MarcinWojewodzic/C5/Hardware/C5W1B1V1.0/Kicad/3D/MP34DT05TR-A.stp

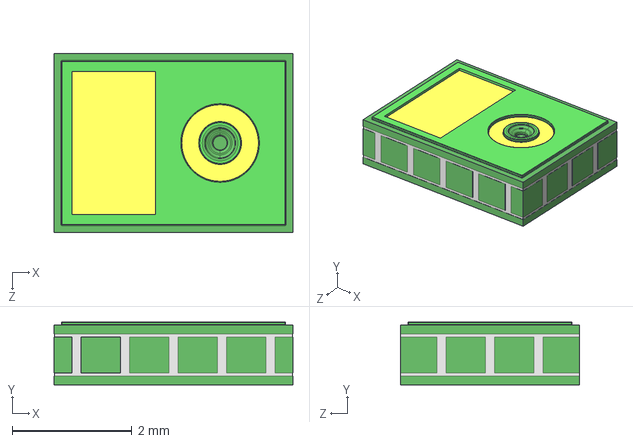
[picture p1: CAD file, 2024-11-15]
Hardware/C5W1B1V1.0/Kicad/3D/MP34DT05TR-A.stp
4.00 x 1.05 x 3.00 mm
