MarcinWojewodzic/C5/Hardware/C5W1B1V1.0/Kicad/3D/RBR10BM60AFHTL.stp

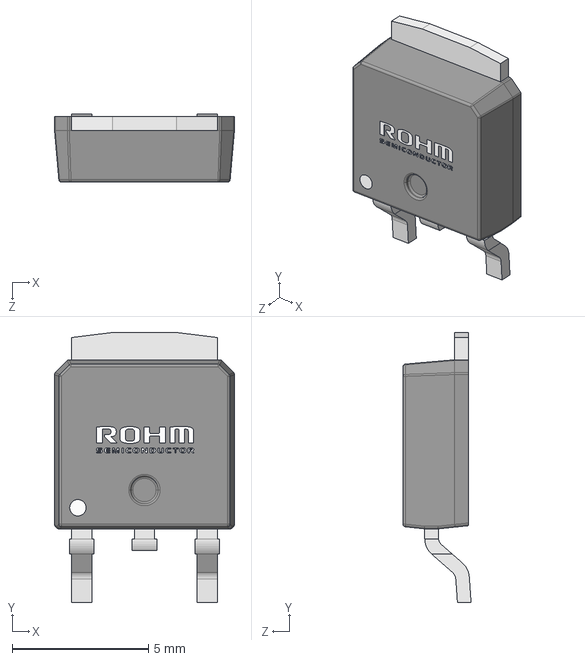
[picture p2: CAD file, 2024-11-08]
Hardware/C5W1B1V1.0/Kicad/3D/RBR10BM60AFHTL.stp
6.60 x 9.90 x 2.50 mm
ROHM TO-252
Rohm Logo-LAPTOP-NQA1DCQ3
