MarcinWojewodzic/C5/Hardware/C5W1B1V1.0/Kicad/3D/SRN6045TA-101M.stp

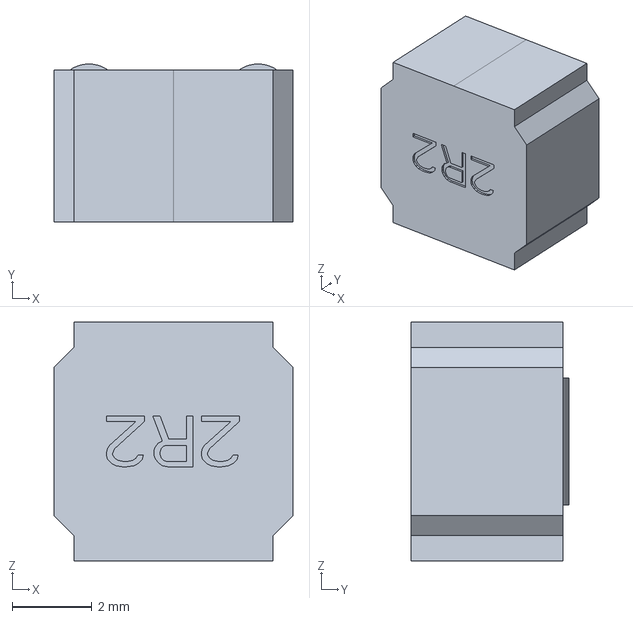
[picture p3: CAD file, 2024-06-30]
Hardware/C5W1B1V1.0/Kicad/3D/SRN6045TA-101M.stp
5.99 x 3.96 x 5.99 mm
