MarcinWojewodzic/C5/Hardware/C5W1B1V1.0/Kicad/3D/0.96in Color OLED.stp

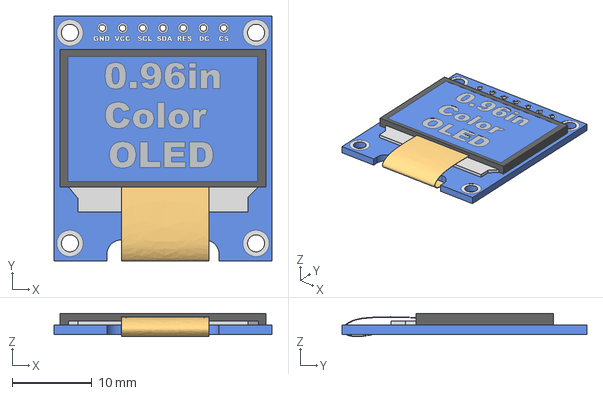
[picture p4: CAD file, 2024-06-27]
Hardware/C5W1B1V1.0/Kicad/3D/0.96in Color OLED.stp
27.4 x 30.8 x 2.92 mm
