MarcinWojewodzic/C5/Hardware/C5W1B1V1.0/Kicad/3D/ESP32-C3-WROOM-02-N4.stp

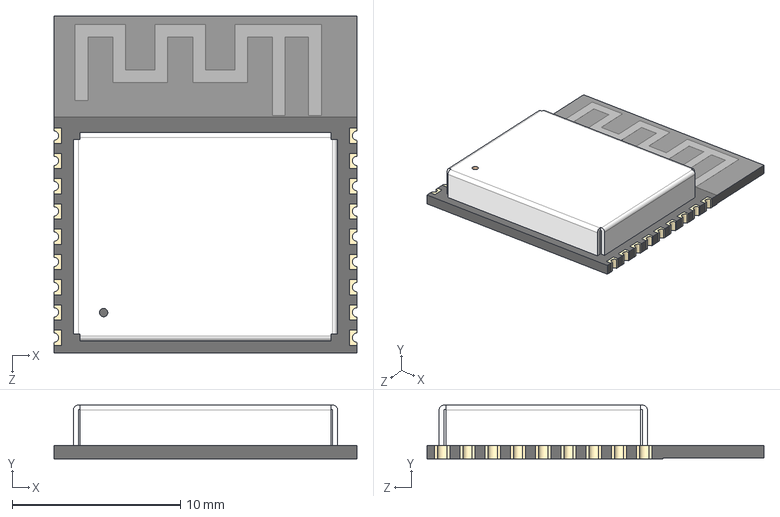
[picture p5: CAD file, 2024-06-08]
Hardware/C5W1B1V1.0/Kicad/3D/ESP32-C3-WROOM-02-N4.stp
18.0 x 3.20 x 20.0 mm
