MarcinWojewodzic/C5/Hardware/C5W1B1V1.0/Kicad/3D/LSM303AHTR.stp

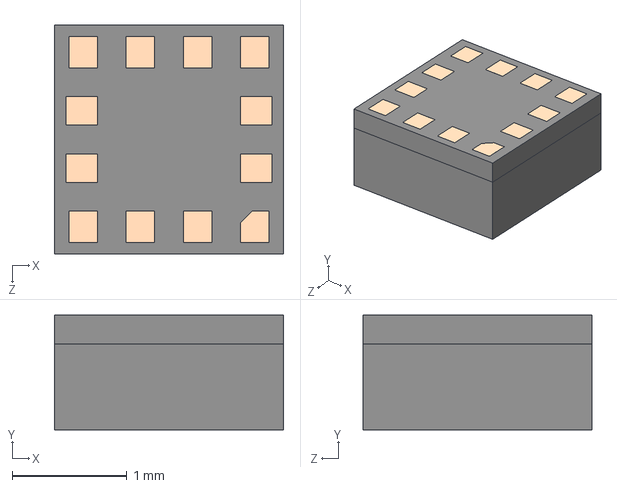
[picture p6: CAD file, 2024-06-08]
Hardware/C5W1B1V1.0/Kicad/3D/LSM303AHTR.stp
2.00 x 1.00 x 2.00 mm
