MarcinWojewodzic/C5/Hardware/C5W1B1V1.0/Kicad/3D/USB4105GFA120.step

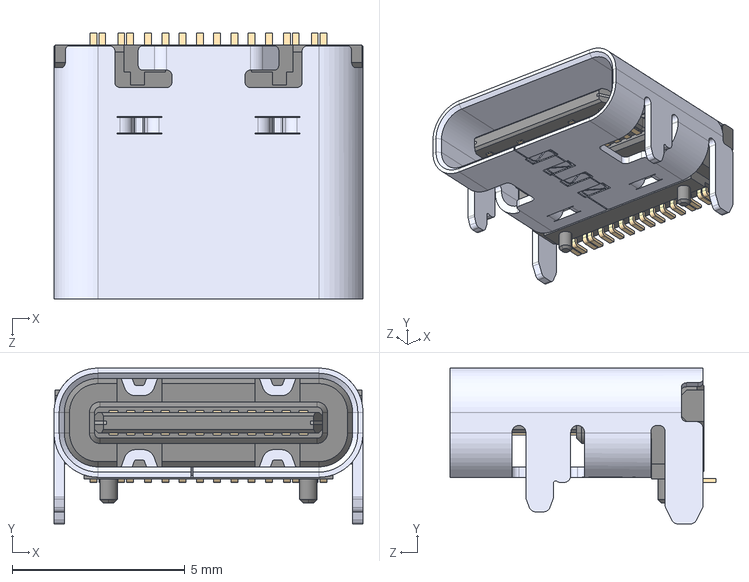
[picture p7: CAD file, 2024-06-08]
Hardware/C5W1B1V1.0/Kicad/3D/USB4105GFA120.step
8.94 x 4.51 x 7.71 mm
