MarcinWojewodzic/C5/Hardware/C5W1B1V1.0/Kicad/3D/USBLC6-2P6.stp

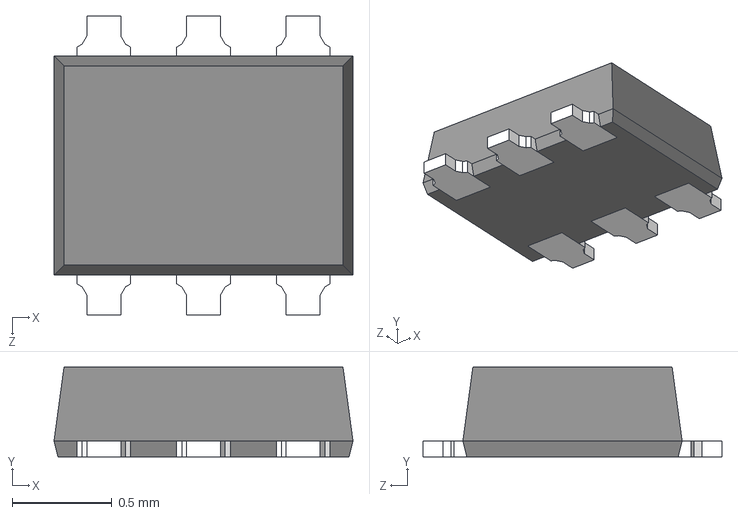
[picture p8: CAD file, 2024-06-08]
Hardware/C5W1B1V1.0/Kicad/3D/USBLC6-2P6.stp
1.50 x 0.45 x 1.50 mm
