MarcinWojewodzic/C5/Hardware/C5W1B1V1.0/Kicad/3D/VL53L0CXV0DH_1.stp

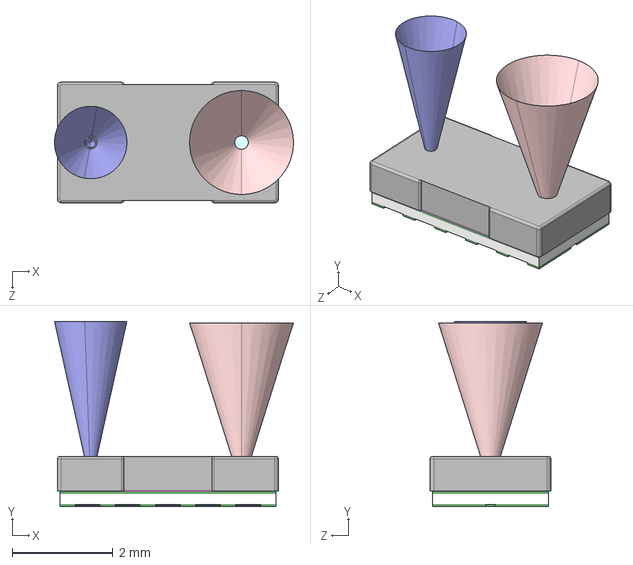
[picture p9: CAD file, 2024-06-08]
Hardware/C5W1B1V1.0/Kicad/3D/VL53L0CXV0DH_1.stp
4.75 x 3.68 x 2.40 mm
DM00266747 - VL53L0 Module
DM00266747 - VL53L0 Exclusion cones
