MarcinWojewodzic/C5/Hardware/C5W1B1V1.0/Kicad/3D/ECS-250-8-36CKM-TR3.stp

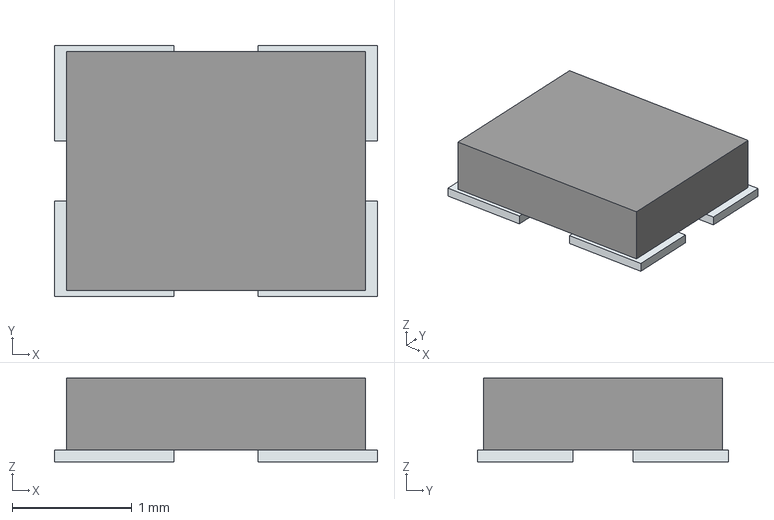
[picture p10: CAD file, 2024-06-08]
Hardware/C5W1B1V1.0/Kicad/3D/ECS-250-8-36CKM-TR3.stp
2.70 x 2.10 x 0.7 mm
Pins
