MarcinWojewodzic/C5/Hardware/C5W1B1V1.0/Kicad/3D/W25N512GVEIG.stp

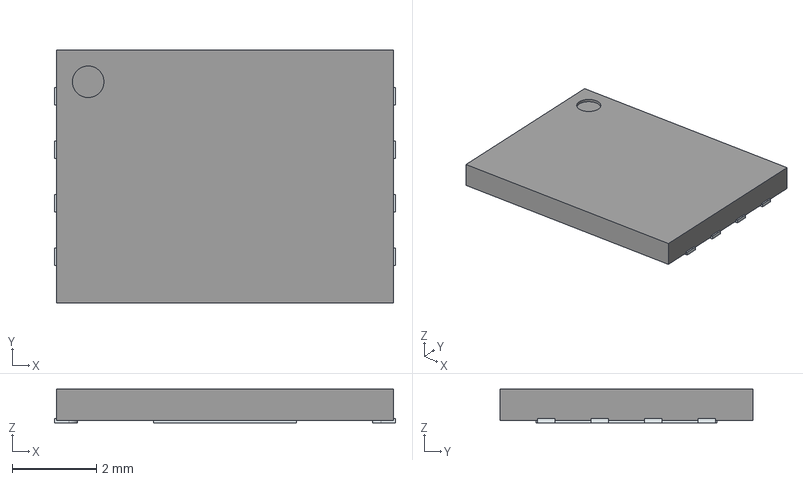
[picture p11: CAD file, 2024-06-08]
Hardware/C5W1B1V1.0/Kicad/3D/W25N512GVEIG.stp
8.10 x 6.00 x 0.8 mm
ThermalPin
PinsArrayLR
