MarcinWojewodzic/C5/Hardware/C5W1B1V1.0/Kicad/3D/ECS-.327-6-17X-C-TR.stp

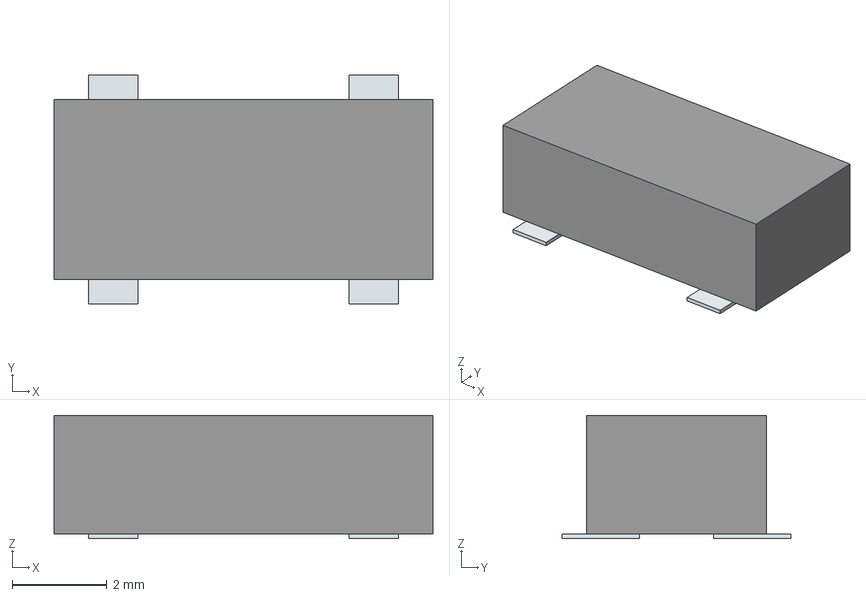
[picture p12: CAD file, 2024-06-08]
Hardware/C5W1B1V1.0/Kicad/3D/ECS-.327-6-17X-C-TR.stp
8.00 x 4.84 x 2.60 mm
Pins
