MarcinWojewodzic/C5/Hardware/C5W1B1V1.0/Kicad/3D/APS6404L-3SQR-SN.stp

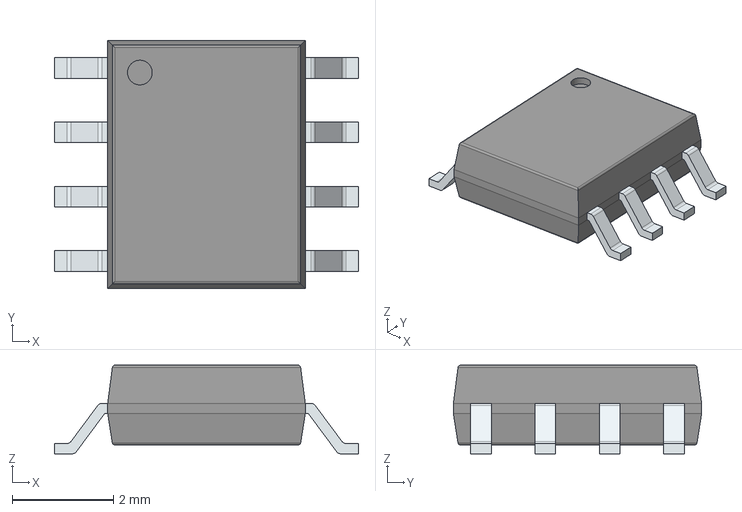
[picture p13: CAD file, 2024-06-08]
Hardware/C5W1B1V1.0/Kicad/3D/APS6404L-3SQR-SN.stp
6.00 x 4.90 x 1.75 mm
PinsArrayLR
