MarcinWojewodzic/C5/Hardware/C5W1B1V1.0/Kicad/3D/MB85RS512TPNF-G-JNERE1.stp

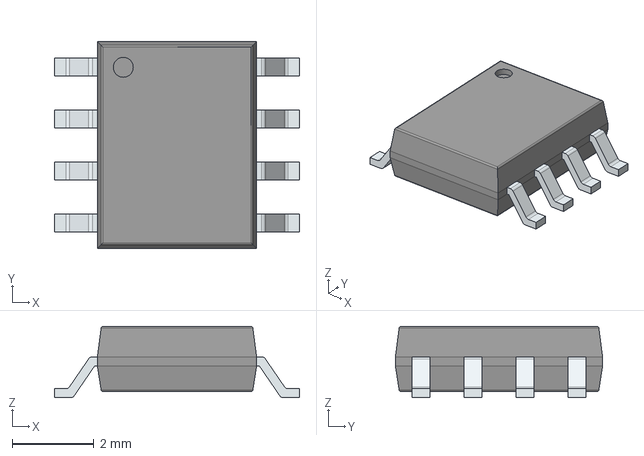
[picture p14: CAD file, 2024-06-08]
Hardware/C5W1B1V1.0/Kicad/3D/MB85RS512TPNF-G-JNERE1.stp
6.00 x 5.08 x 1.75 mm
PinsArrayLR
