MarcinWojewodzic/C5/Hardware/C5W1B1V1.0/Kicad/3D/BME688.stp

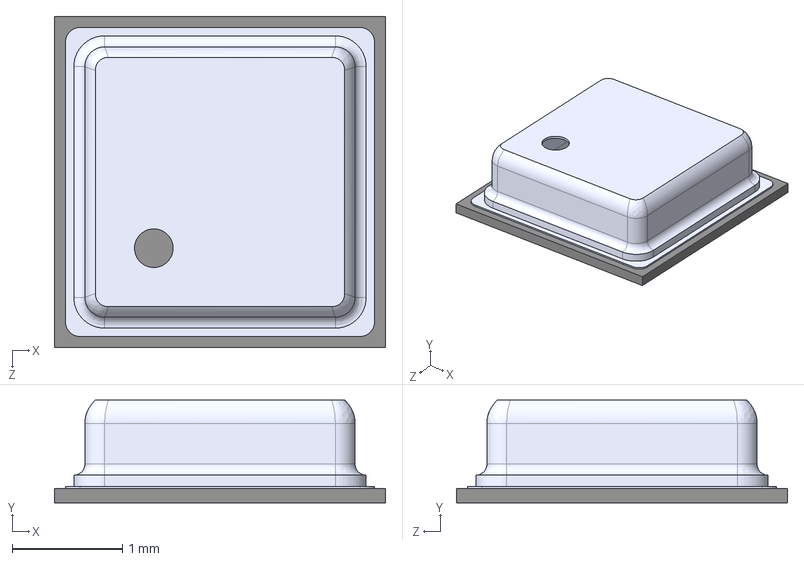
[picture p15: CAD file, 2023-05-07]
Hardware/C5W1B1V1.0/Kicad/3D/BME688.stp
3.00 x 0.93 x 3.00 mm
