MarcinWojewodzic/C5/Hardware/C5W1B1V1.0/Kicad/3D/LD39200PU33R.stp

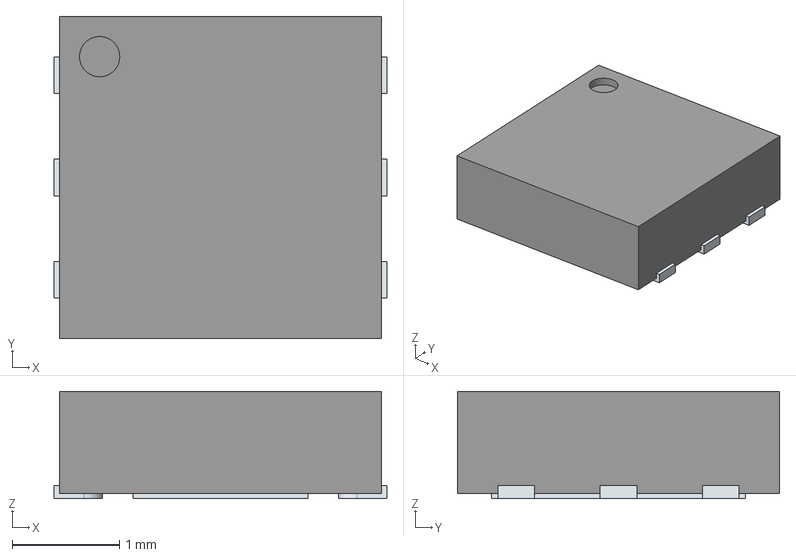
[picture p16: CAD file, 2024-11-08]
Hardware/C5W1B1V1.0/Kicad/3D/LD39200PU33R.stp
3.10 x 3.00 x 1.00 mm
ThermalPin
PinsArrayLR
