MarcinWojewodzic/C5/Hardware/C5W1B1V1.0/Kicad/3D/LMR62421XSD_NOPB.stp

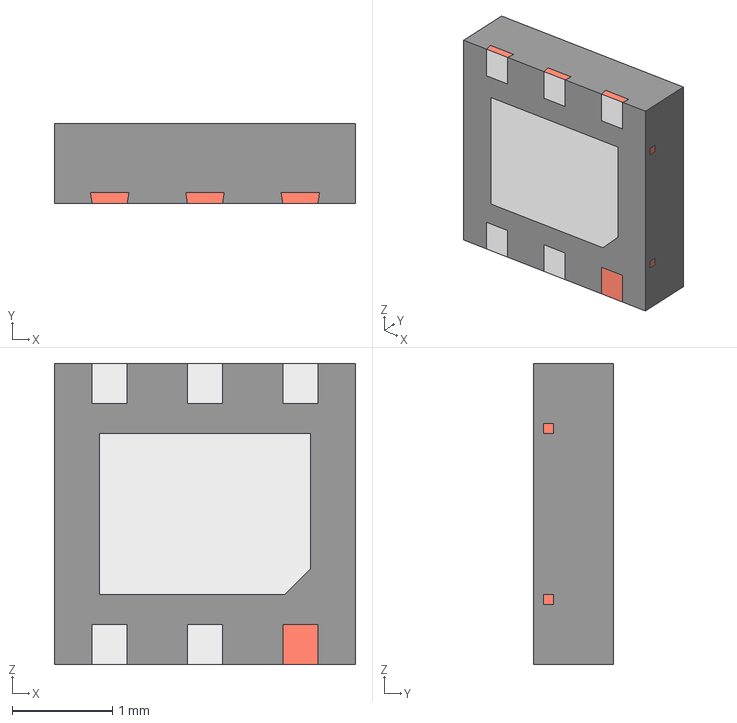
[picture p17: CAD file, 2024-06-30]
Hardware/C5W1B1V1.0/Kicad/3D/LMR62421XSD_NOPB.stp
3.00 x 0.8 x 3.00 mm
BODY_SDE06A
FRAME_SDE06A
