MarcinWojewodzic/C5/Hardware/C5W1B1V1.0/Kicad/3D/216990-0003.stp

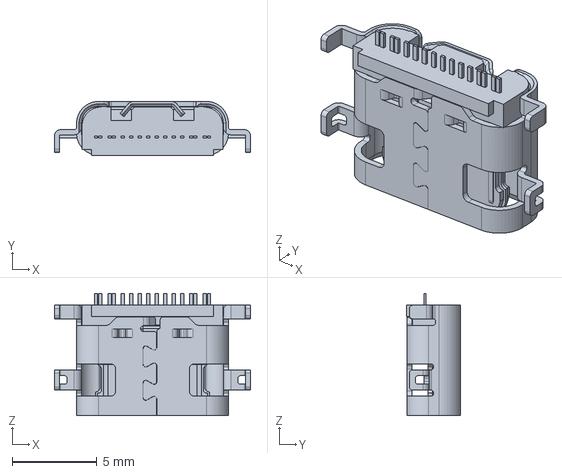
[picture p18: CAD file, 2024-06-08]
Hardware/C5W1B1V1.0/Kicad/3D/216990-0003.stp
11.5 x 3.18 x 7.20 mm
