MarcinWojewodzic/C5/Hardware/C5W1B1V1.0/Kicad/C5W1B1V1.0.kicad_pcb

## KiCad design Hardware/C5W1B1V1.0/Kicad/C5W1B1V1.0.kicad_pcb (2024-11-15)

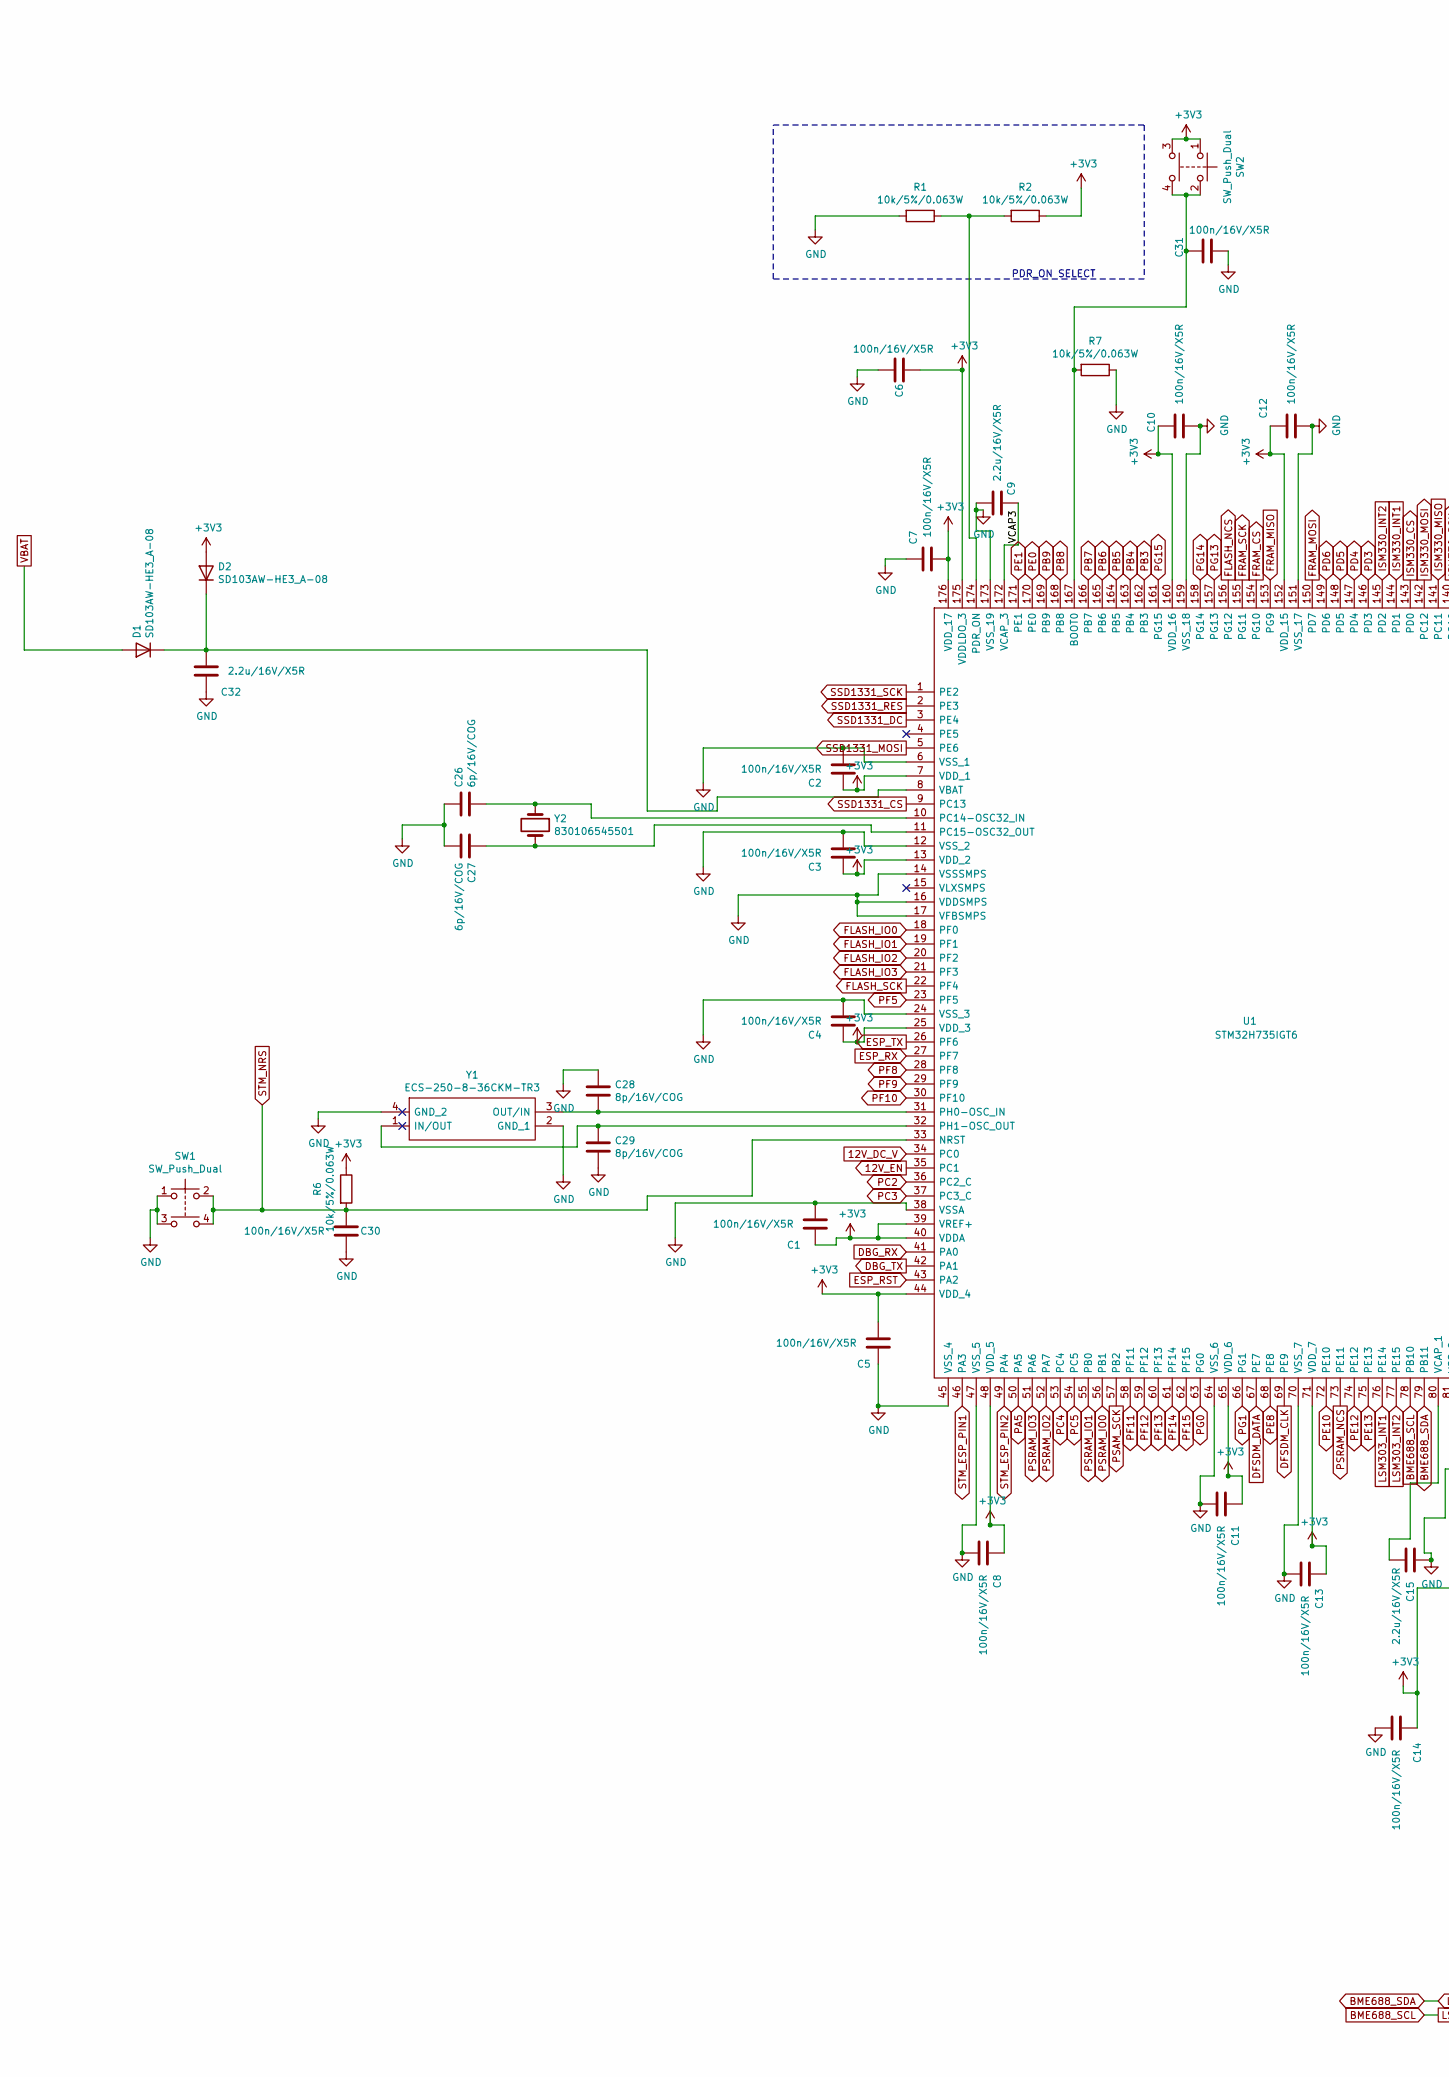
[picture p19: schematic uC.sch, part in row 1, column 1]

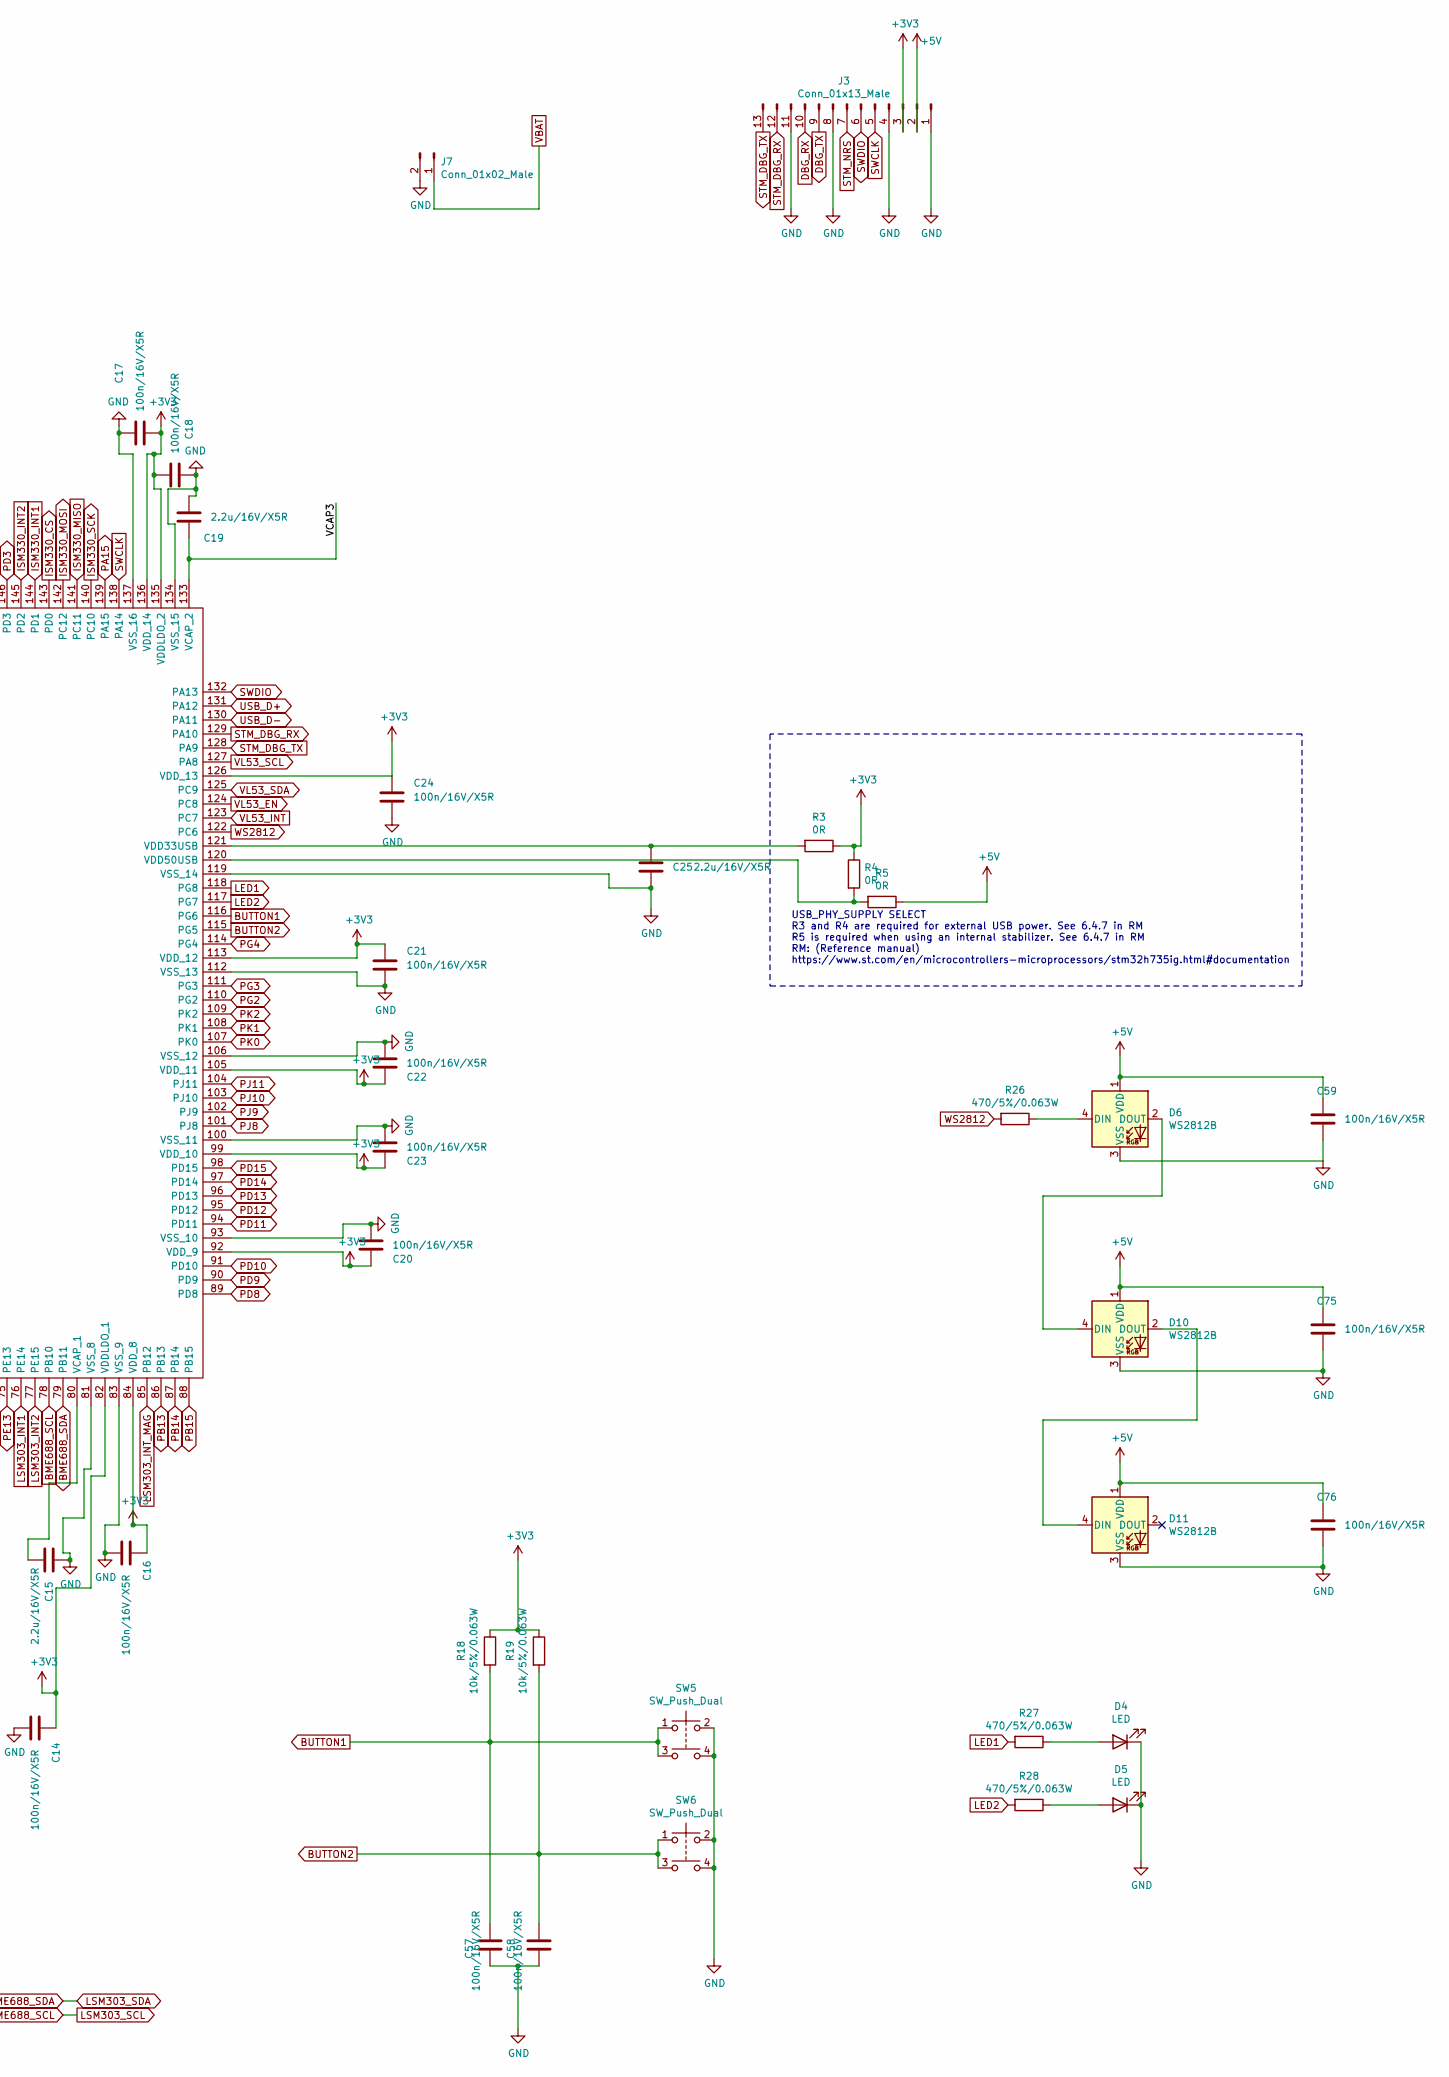
[picture p20: schematic uC.sch, part in row 1, column 2]

Parts:
C1, C2, C3, C4, C5, C6, C7, C8, C10, C11, C12, C13, C14, C16, C17, C18, C20, C21, C22, C23, C24, C30, C31, C57, C58, C59, C75, C76: 100n/16V/X5R; C_0402_1005Metric
C9, C15, C19, C25, C32: 2.2u/16V/X5R; C_0402_1005Metric
C26, C27: 6p/16V/COG; C_0402_1005Metric
C28, C29: 8p/16V/COG; C_0402_1005Metric
D1, D2: SD103AW-HE3_A-08; D_SOD-123
D4, D5: LED; LED_0805_2012Metric
D6, D10, D11: WS2812B; LED_WS2812B_PLCC4_5.0x5.0mm_P3.2mm
J3: Conn_01x13_Male; PinHeader_1x13_P2.54mm_Vertical
J7: Conn_01x02_Male; PinHeader_1x02_P2.54mm_Vertical
R1, R2, R6, R7, R18, R19: 10k/5%/0.063W; R_0402_1005Metric
R3, R4, R5: 0R; R_0402_1005Metric
R26, R27, R28: 470/5%/0.063W; R_0402_1005Metric
SW1, SW2, SW5, SW6: SW_Push_Dual; SW_Push_1P1T_NO_6x6mm_H9.5mm
U1: STM32H735IGT6; QFP50P2600X2600X160-176N; Manufacturer_Part_Number STM32H735IGT6; Mouser Part Number 511-STM32H735IGT6
Y1: ECS-250-8-36CKM-TR3; Crystal_SMD_2520-4Pin_2.5x2.0mm; Manufacturer_Part_Number ECS-250-8-36CKM-TR3; Mouser Part Number 520-250-8-36CKM-TR3
Y2: 830106545501; Crystal_SMD_2012-2Pin_2.0x1.2mm

Connections:
12V_DC_V: U1.34 (PC0); also elsewhere on the board
12V_EN: U1.35 (PC1); also elsewhere on the board
+3V3: C1.1, C2.1, C3.1, C4.1, C5.2, C6.2, C7.2, C8.1, C10.1, C11.1, C12.1, C13.1, C14.1, C16.1, C17.2, C18.1, C20.2, C21.1, C22.2, C23.2, C24.1, D2.2 (A), J3.3, R2.1, R3.1, R4.1, R6.1, R18.1, R19.1, SW2.1, SW2.3, U1.7 (VDD_1), U1.13 (VDD_2), U1.25 (VDD_3), U1.39 (VREF+), U1.40 (VDDA), U1.44 (VDD_4), U1.48 (VDD_5), U1.65 (VDD_6), U1.71 (VDD_7), U1.82 (VDDLDO_1), U1.84 (VDD_8), U1.92 (VDD_9), U1.99 (VDD_10), U1.105 (VDD_11), U1.113 (VDD_12), U1.126 (VDD_13), U1.135 (VDDLDO_2), U1.136 (VDD_14), U1.152 (VDD_15), U1.160 (VDD_16), U1.175 (VDDLDO_3), U1.176 (VDD_17); also elsewhere on the board
+5V: C59.1, C75.1, C76.1, D6.1 (VDD), D10.1 (VDD), D11.1 (VDD), J3.2, R5.1; also elsewhere on the board
/uC/VCAP3: C9.2, C19.2, U1.133 (VCAP_2), U1.172 (VCAP_3)
BME688_SCL: U1.78 (PB10); also elsewhere on the board
BME688_SDA: U1.79 (PB11); also elsewhere on the board
BUTTON1: C57.2, R18.2, SW5.1, SW5.3, U1.116 (PG6)
BUTTON2: C58.2, R19.2, SW6.1, SW6.3, U1.115 (PG5)
DBG_RX: J3.10, U1.41 (PA0); also elsewhere on the board
DBG_TX: J3.9, U1.42 (PA1); also elsewhere on the board
DFSDM_CLK: U1.69 (PE9); also elsewhere on the board
DFSDM_DATA: U1.67 (PE7); also elsewhere on the board
ESP_RST: U1.43 (PA2); also elsewhere on the board
ESP_RX: U1.27 (PF7); also elsewhere on the board
ESP_TX: U1.26 (PF6); also elsewhere on the board
FLASH_IO0: U1.18 (PF0); also elsewhere on the board
FLASH_IO1: U1.19 (PF1); also elsewhere on the board
FLASH_IO2: U1.20 (PF2); also elsewhere on the board
FLASH_IO3: U1.21 (PF3); also elsewhere on the board
FLASH_NCS: U1.156 (PG12); also elsewhere on the board
FLASH_SCK: U1.22 (PF4); also elsewhere on the board
FRAM_CS: U1.154 (PG10); also elsewhere on the board
FRAM_MISO: U1.153 (PG9); also elsewhere on the board
FRAM_MOSI: U1.150 (PD7); also elsewhere on the board
FRAM_SCK: U1.155 (PG11); also elsewhere on the board
GND: C1.2, C2.2, C3.2, C4.2, C5.1, C6.1, C7.1, C8.2, C9.1, C10.2, C11.2, C12.2, C13.2, C14.2, C15.1, C16.2, C17.1, C18.2, C19.1, C20.1, C21.2, C22.1, C23.1, C24.2, C25.2, C26.1, C27.2, C28.1, C29.2, C30.1, C31.2, C32.2, C57.1, C58.1, C59.2, C75.2, C76.2, D4.1 (K), D5.1 (K), D6.3 (VSS), D10.3 (VSS), D11.3 (VSS), J3.1, J3.4, J3.8, J3.11, J7.2, R1.2, R7.1, SW1.1, SW1.3, SW5.2, SW5.4, SW6.2, SW6.4, U1.6 (VSS_1), U1.12 (VSS_2), U1.14 (VSSSMPS), U1.16 (VDDSMPS), U1.17 (VFBSMPS), U1.24 (VSS_3), U1.38 (VSSA), U1.45 (VSS_4), U1.47 (VSS_5), U1.64 (VSS_6), U1.70 (VSS_7), U1.81 (VSS_8), U1.83 (VSS_9), U1.93 (VSS_10), U1.100 (VSS_11), U1.106 (VSS_12), U1.112 (VSS_13), U1.119 (VSS_14), U1.134 (VSS_15), U1.137 (VSS_16), U1.151 (VSS_17), U1.159 (VSS_18), U1.173 (VSS_19), Y1.2 (GND_1), Y1.4 (GND_2); also elsewhere on the board
ISM330_CS: U1.143 (PD0); also elsewhere on the board
ISM330_INT1: U1.144 (PD1); also elsewhere on the board
ISM330_INT2: U1.145 (PD2); also elsewhere on the board
ISM330_MISO: U1.141 (PC11); also elsewhere on the board
ISM330_MOSI: U1.142 (PC12); also elsewhere on the board
ISM330_SCK: U1.140 (PC10); also elsewhere on the board
LED1: R27.2, U1.118 (PG8)
LED2: R28.2, U1.117 (PG7)
LSM303_INT1: U1.76 (PE14); also elsewhere on the board
LSM303_INT2: U1.77 (PE15); also elsewhere on the board
LSM303_INT_MAG: U1.85 (PB12); also elsewhere on the board
unnamed: C15.2, U1.80 (VCAP_1)
unnamed: C25.1, R3.2, U1.121 (VDD33USB)
unnamed: C26.2, U1.10 (PC14-OSC32_IN), Y2.1
unnamed: C27.1, U1.11 (PC15-OSC32_OUT), Y2.2
unnamed: C28.2, U1.31 (PH0-OSC_IN), Y1.3 (OUT/IN)
unnamed: C29.1, U1.32 (PH1-OSC_OUT), Y1.1 (IN/OUT)
unnamed: C31.1, R7.2, SW2.2, SW2.4, U1.167 (BOOT0)
unnamed: C32.1, D1.1 (K), D2.1 (K), U1.8 (VBAT)
unnamed: D4.2 (A), R27.1
unnamed: D5.2 (A), R28.1
unnamed: D6.4 (DIN), R26.1
unnamed: D10.2 (DOUT), D11.4 (DIN)
unnamed: D6.2 (DOUT), D10.4 (DIN)
unnamed: R1.1, R2.2, U1.174 (PDR_ON)
unnamed: R4.2, R5.2, U1.120 (VDD50USB)
PA5: U1.50 (PA5); also elsewhere on the board
PA15: U1.139 (PA15); also elsewhere on the board
PB3: U1.162 (PB3); also elsewhere on the board
PB4: U1.163 (PB4); also elsewhere on the board
PB5: U1.164 (PB5); also elsewhere on the board
PB6: U1.165 (PB6); also elsewhere on the board
PB7: U1.166 (PB7); also elsewhere on the board
PB8: U1.168 (PB8); also elsewhere on the board
PB9: U1.169 (PB9); also elsewhere on the board
PB13: U1.86 (PB13); also elsewhere on the board
PB14: U1.87 (PB14); also elsewhere on the board
PB15: U1.88 (PB15); also elsewhere on the board
PC2: U1.36 (PC2_C); also elsewhere on the board
PC3: U1.37 (PC3_C); also elsewhere on the board
PC4: U1.53 (PC4); also elsewhere on the board
PC5: U1.54 (PC5); also elsewhere on the board
PD3: U1.146 (PD3); also elsewhere on the board
PD4: U1.147 (PD4); also elsewhere on the board
PD5: U1.148 (PD5); also elsewhere on the board
PD6: U1.149 (PD6); also elsewhere on the board
PD8: U1.89 (PD8); also elsewhere on the board
PD9: U1.90 (PD9); also elsewhere on the board
PD10: U1.91 (PD10); also elsewhere on the board
PD11: U1.94 (PD11); also elsewhere on the board
PD12: U1.95 (PD12); also elsewhere on the board
PD13: U1.96 (PD13); also elsewhere on the board
PD14: U1.97 (PD14); also elsewhere on the board
PD15: U1.98 (PD15); also elsewhere on the board
PE0: U1.170 (PE0); also elsewhere on the board
PE1: U1.171 (PE1); also elsewhere on the board
PE8: U1.68 (PE8); also elsewhere on the board
PE10: U1.72 (PE10); also elsewhere on the board
PE12: U1.74 (PE12); also elsewhere on the board
PE13: U1.75 (PE13); also elsewhere on the board
PF5: U1.23 (PF5); also elsewhere on the board
PF8: U1.28 (PF8); also elsewhere on the board
PF9: U1.29 (PF9); also elsewhere on the board
PF10: U1.30 (PF10); also elsewhere on the board
PF11: U1.58 (PF11); also elsewhere on the board
PF12: U1.59 (PF12); also elsewhere on the board
PF13: U1.60 (PF13); also elsewhere on the board
PF14: U1.61 (PF14); also elsewhere on the board
PF15: U1.62 (PF15); also elsewhere on the board
PG0: U1.63 (PG0); also elsewhere on the board
PG1: U1.66 (PG1); also elsewhere on the board
PG2: U1.110 (PG2); also elsewhere on the board
PG3: U1.111 (PG3); also elsewhere on the board
PG4: U1.114 (PG4); also elsewhere on the board
PG13: U1.157 (PG13); also elsewhere on the board
PG14: U1.158 (PG14); also elsewhere on the board
PG15: U1.161 (PG15); also elsewhere on the board
PJ8: U1.101 (PJ8); also elsewhere on the board
PJ9: U1.102 (PJ9); also elsewhere on the board
PJ10: U1.103 (PJ10); also elsewhere on the board
PJ11: U1.104 (PJ11); also elsewhere on the board
PK0: U1.107 (PK0); also elsewhere on the board
PK1: U1.108 (PK1); also elsewhere on the board
PK2: U1.109 (PK2); also elsewhere on the board
PSAM_SCK: U1.57 (PB2); also elsewhere on the board
PSRAM_IO0: U1.56 (PB1); also elsewhere on the board
PSRAM_IO1: U1.55 (PB0); also elsewhere on the board
PSRAM_IO2: U1.52 (PA7); also elsewhere on the board
PSRAM_IO3: U1.51 (PA6); also elsewhere on the board
PSRAM_NCS: U1.73 (PE11); also elsewhere on the board
SSD1331_CS: U1.9 (PC13); also elsewhere on the board
SSD1331_DC: U1.3 (PE4); also elsewhere on the board
SSD1331_MOSI: U1.5 (PE6); also elsewhere on the board
SSD1331_RES: U1.2 (PE3); also elsewhere on the board
SSD1331_SCK: U1.1 (PE2); also elsewhere on the board
STM_DBG_RX: J3.12, U1.129 (PA10)
STM_DBG_TX: J3.13, U1.128 (PA9)
STM_ESP_PIN1: U1.46 (PA3); also elsewhere on the board
STM_ESP_PIN2: U1.49 (PA4); also elsewhere on the board
STM_NRS: C30.2, J3.7, R6.2, SW1.2, SW1.4, U1.33 (NRST)
SWCLK: J3.5, U1.138 (PA14)
SWDIO: J3.6, U1.132 (PA13)
USB_D+: U1.131 (PA12); also elsewhere on the board
USB_D-: U1.130 (PA11); also elsewhere on the board
VBAT: D1.2 (A), J7.1
VL53_EN: U1.124 (PC8); also elsewhere on the board
VL53_INT: U1.123 (PC7); also elsewhere on the board
VL53_SCL: U1.127 (PA8); also elsewhere on the board
VL53_SDA: U1.125 (PC9); also elsewhere on the board
WS2812: R26.2, U1.122 (PC6)

Notes on the sheet:
PDR_ON SELECT
USB_PHY_SUPPLY SELECT R3 and R4 are required for external USB power. See 6.4.7 in RM R5 is required when using an internal stabilizer. See 6.4.7 in RM RM: (Reference manual) https://www.st.com/en/microcontrollers-microprocessors/stm32h735ig.html#documentation

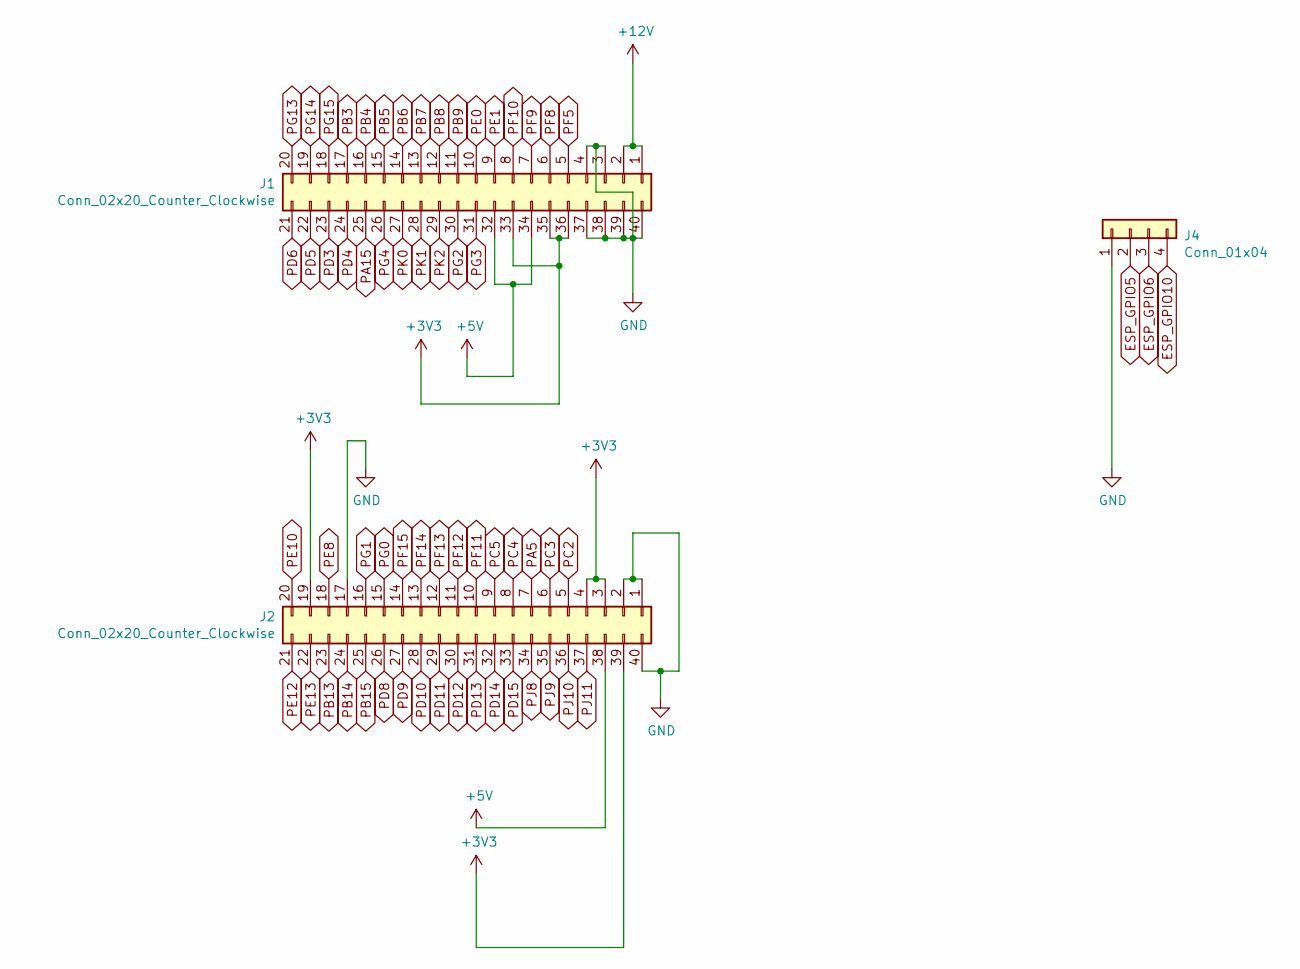
[picture p21: schematic IO.sch]

Parts:
J1, J2: Conn_02x20_Counter_Clockwise; PinHeader_2x20_P2.54mm_Vertical
J4: Conn_01x04; PinHeader_1x04_P2.54mm_Vertical

Connections:
+3V3: J1.33, J1.35, J1.36, J2.3, J2.4, J2.19, J2.39; also elsewhere on the board
+5V: J1.32, J1.34, J2.38; also elsewhere on the board
+12V: J1.1, J1.2; also elsewhere on the board
ESP_GPIO5: J4.2; also elsewhere on the board
ESP_GPIO6: J4.3; also elsewhere on the board
ESP_GPIO10: J4.4; also elsewhere on the board
GND: J1.3, J1.4, J1.37, J1.38, J1.39, J1.40, J2.1, J2.2, J2.17, J2.40, J4.1; also elsewhere on the board
PA5: J2.7; also elsewhere on the board
PA15: J1.25; also elsewhere on the board
PB3: J1.17; also elsewhere on the board
PB4: J1.16; also elsewhere on the board
PB5: J1.15; also elsewhere on the board
PB6: J1.14; also elsewhere on the board
PB7: J1.13; also elsewhere on the board
PB8: J1.12; also elsewhere on the board
PB9: J1.11; also elsewhere on the board
PB13: J2.23; also elsewhere on the board
PB14: J2.24; also elsewhere on the board
PB15: J2.25; also elsewhere on the board
PC2: J2.5; also elsewhere on the board
PC3: J2.6; also elsewhere on the board
PC4: J2.8; also elsewhere on the board
PC5: J2.9; also elsewhere on the board
PD3: J1.23; also elsewhere on the board
PD4: J1.24; also elsewhere on the board
PD5: J1.22; also elsewhere on the board
PD6: J1.21; also elsewhere on the board
PD8: J2.26; also elsewhere on the board
PD9: J2.27; also elsewhere on the board
PD10: J2.28; also elsewhere on the board
PD11: J2.29; also elsewhere on the board
PD12: J2.30; also elsewhere on the board
PD13: J2.31; also elsewhere on the board
PD14: J2.32; also elsewhere on the board
PD15: J2.33; also elsewhere on the board
PE0: J1.10; also elsewhere on the board
PE1: J1.9; also elsewhere on the board
PE8: J2.18; also elsewhere on the board
PE10: J2.20; also elsewhere on the board
PE12: J2.21; also elsewhere on the board
PE13: J2.22; also elsewhere on the board
PF5: J1.5; also elsewhere on the board
PF8: J1.6; also elsewhere on the board
PF9: J1.7; also elsewhere on the board
PF10: J1.8; also elsewhere on the board
PF11: J2.10; also elsewhere on the board
PF12: J2.11; also elsewhere on the board
PF13: J2.12; also elsewhere on the board
PF14: J2.13; also elsewhere on the board
PF15: J2.14; also elsewhere on the board
PG0: J2.15; also elsewhere on the board
PG1: J2.16; also elsewhere on the board
PG2: J1.30; also elsewhere on the board
PG3: J1.31; also elsewhere on the board
PG4: J1.26; also elsewhere on the board
PG13: J1.20; also elsewhere on the board
PG14: J1.19; also elsewhere on the board
PG15: J1.18; also elsewhere on the board
PJ8: J2.34; also elsewhere on the board
PJ9: J2.35; also elsewhere on the board
PJ10: J2.36; also elsewhere on the board
PJ11: J2.37; also elsewhere on the board
PK0: J1.27; also elsewhere on the board
PK1: J1.28; also elsewhere on the board
PK2: J1.29; also elsewhere on the board

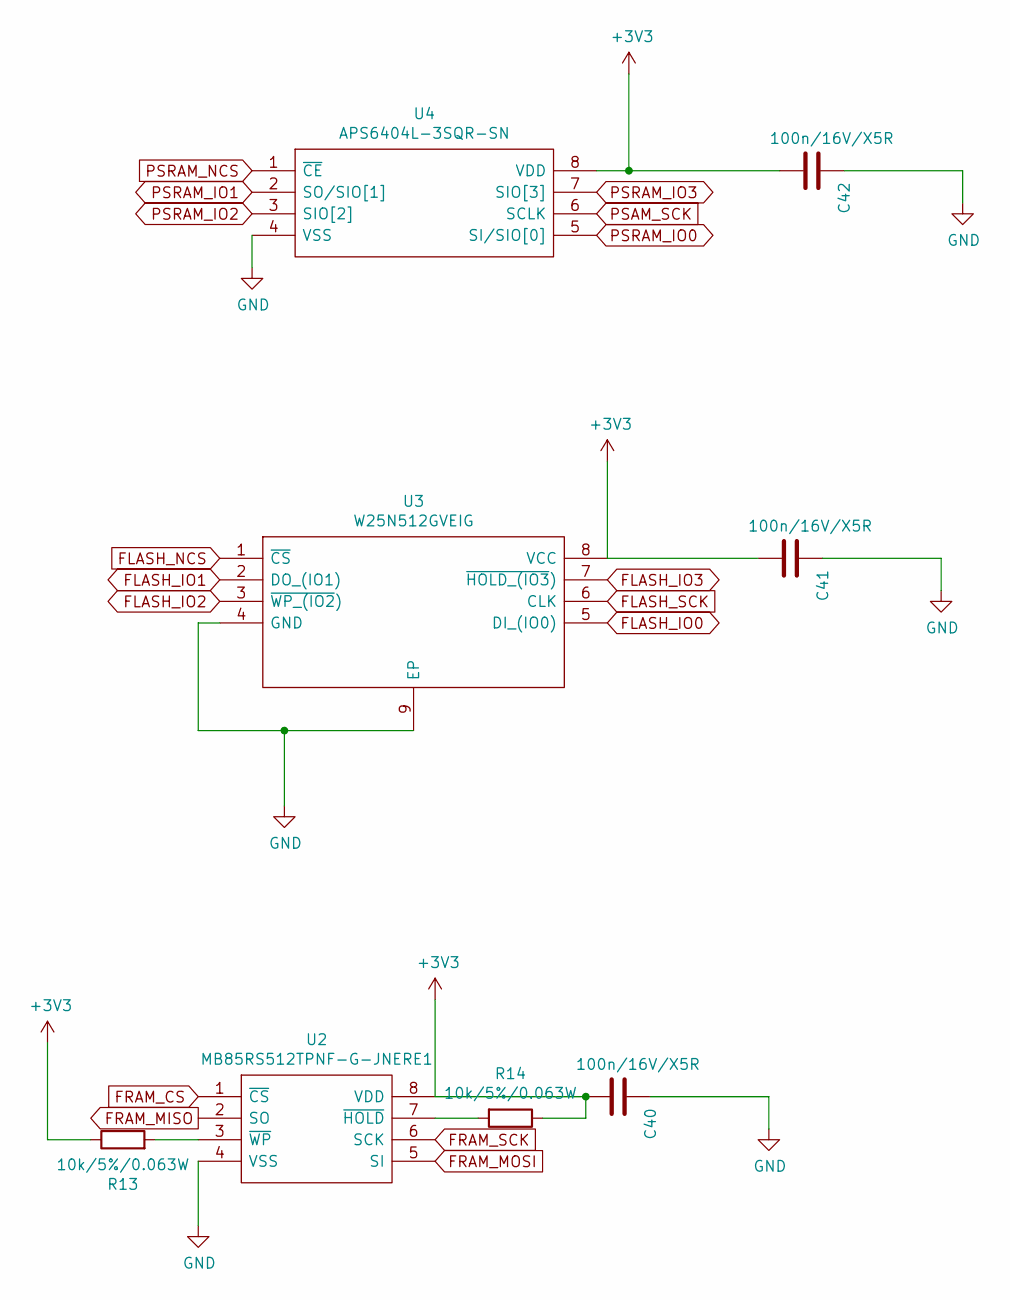
[picture p22: schematic Memories.sch]

Parts:
C40, C41, C42: 100n/16V/X5R; C_0402_1005Metric
R13, R14: 10k/5%/0.063W; R_0402_1005Metric
U2: MB85RS512TPNF-G-JNERE1; SOIC127P600X175-8N; Manufacturer_Part_Number MB85RS512TPNF-G-JNERE1; Mouser Part Number 249-85S512TPNFGJNR1
U3: W25N512GVEIG; SON127P800X600X80-9N-D; Manufacturer_Part_Number W25N512GVEIG; Mouser Part Number 454-W25N512GVEIG
U4: APS6404L-3SQR-SN; SOIC127P600X175-8N; Manufacturer_Part_Number APS6404L-3SQR-SN; Mouser Part Number 878-APS6404L-3SQR-SN

Connections:
+3V3: C40.2, C41.2, C42.2, R13.1, R14.1, U2.8 (VDD), U3.8 (VCC), U4.8 (VDD); also elsewhere on the board
FLASH_IO0: U3.5 (DI_(IO0)); also elsewhere on the board
FLASH_IO1: U3.2 (DO_(IO1)); also elsewhere on the board
FLASH_IO2: U3.3 (~WP_(IO2)); also elsewhere on the board
FLASH_IO3: U3.7 (~HOLD_(IO3)); also elsewhere on the board
FLASH_NCS: U3.1 (~CS); also elsewhere on the board
FLASH_SCK: U3.6 (CLK); also elsewhere on the board
FRAM_CS: U2.1 (~CS); also elsewhere on the board
FRAM_MISO: U2.2 (SO); also elsewhere on the board
FRAM_MOSI: U2.5 (SI); also elsewhere on the board
FRAM_SCK: U2.6 (SCK); also elsewhere on the board
GND: C40.1, C41.1, C42.1, U2.4 (VSS), U3.4 (GND), U3.9 (EP), U4.4 (VSS); also elsewhere on the board
unnamed: R13.2, U2.3 (~WP)
unnamed: R14.2, U2.7 (~HOLD)
PSAM_SCK: U4.6 (SCLK); also elsewhere on the board
PSRAM_IO0: U4.5 (SI/SIO[0]); also elsewhere on the board
PSRAM_IO1: U4.2 (SO/SIO[1]); also elsewhere on the board
PSRAM_IO2: U4.3 (SIO[2]); also elsewhere on the board
PSRAM_IO3: U4.7 (SIO[3]); also elsewhere on the board
PSRAM_NCS: U4.1 (~CE); also elsewhere on the board

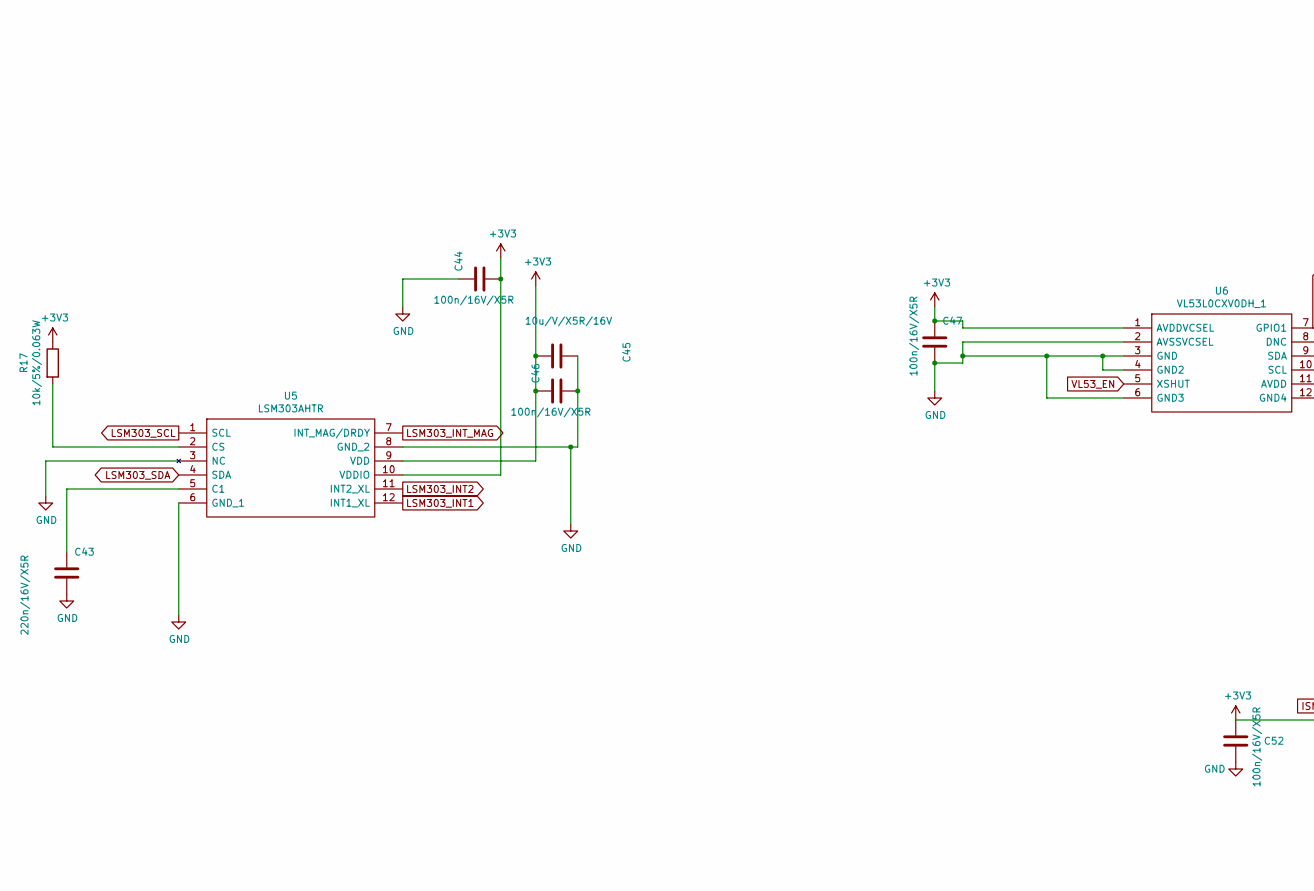
[picture p23: schematic Sensors.sch, part in row 1, column 1]

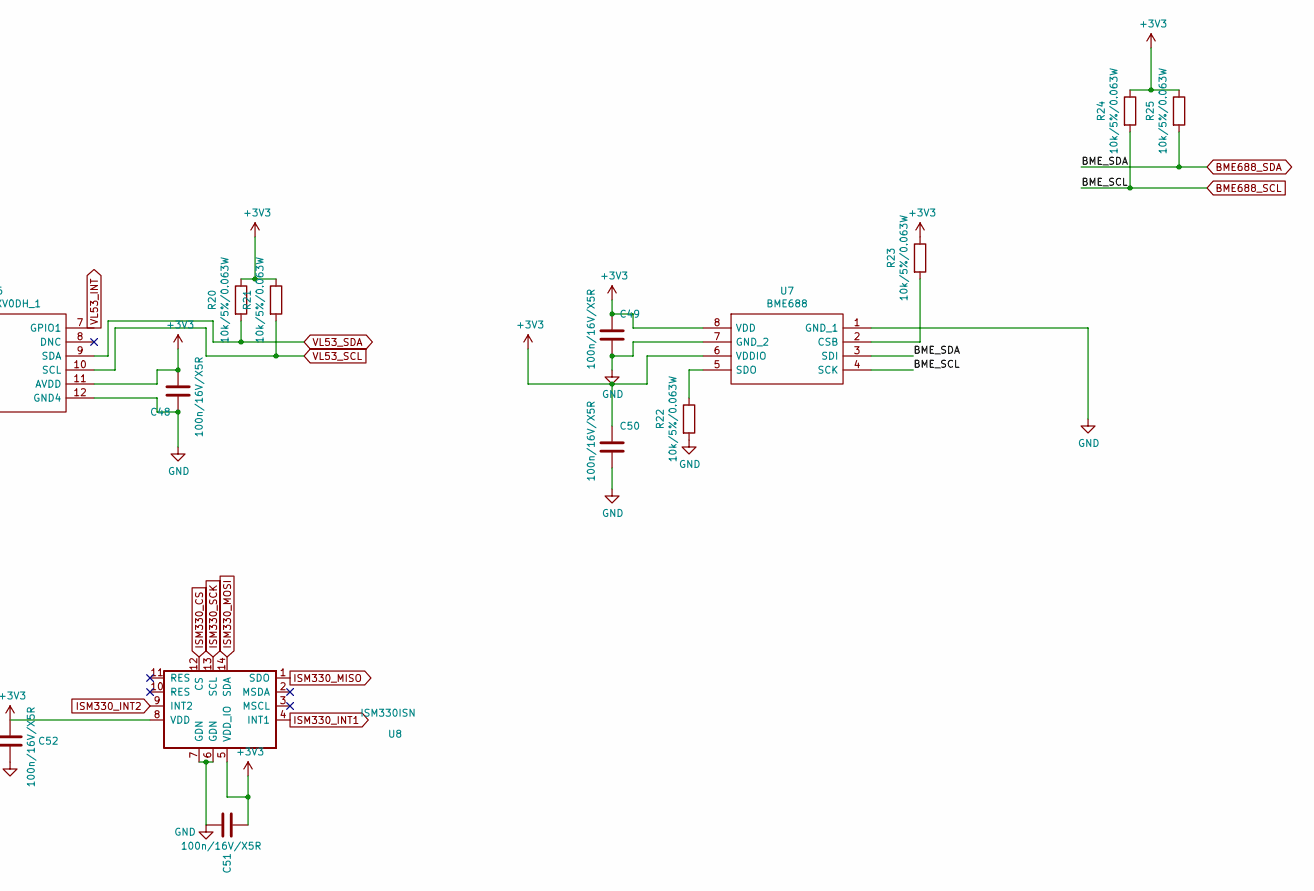
[picture p24: schematic Sensors.sch, part in row 1, column 2]

Parts:
C43: 220n/16V/X5R; C_0402_1005Metric
C44, C46, C47, C48, C49, C50, C51, C52: 100n/16V/X5R; C_0402_1005Metric
C45: 10u/V/X5R/16V; C_0402_1005Metric
R17, R20, R21, R22, R23, R24, R25: 10k/5%/0.063W; R_0402_1005Metric
U5: LSM303AHTR; LGA-12_2x2mm_P0.5mm; Manufacturer_Part_Number LSM303AHTR; Mouser Part Number 511-LSM303AHTR
U6: VL53L0CXV0DH_1; LGA12_1; Manufacturer_Part_Number VL53L0CXV0DH/1; Mouser Part Number 511-VL53L0CXV0DH/1
U7: BME688; Manufacturer_Part_Number BME688; Mouser Part Number 262-BME688
U8: ISM330ISN; Bosch_LGA-14_3x2.5mm_P0.5mm

Connections:
+3V3: C44.2, C45.1, C46.1, C47.1, C48.2, C49.1, C50.1, C51.2, C52.2, R17.1, R20.1, R21.1, R23.1, R24.1, R25.1, U5.9 (VDD), U5.10 (VDDIO), U6.1 (AVDDVCSEL), U6.11 (AVDD), U7.6 (VDDIO), U7.8 (VDD), U8.5 (VDD_IO), U8.8 (VDD); also elsewhere on the board
BME688_SCL: R24.2, U5.1 (SCL), U7.4 (SCK); also elsewhere on the board
BME688_SDA: R25.2, U5.4 (SDA), U7.3 (SDI); also elsewhere on the board
GND: C43.2, C44.1, C45.2, C46.2, C47.2, C48.1, C49.2, C50.2, C51.1, C52.1, R22.2, U5.3 (NC), U5.6 (GND_1), U5.8 (GND_2), U6.2 (AVSSVCSEL), U6.3 (GND), U6.4 (GND2), U6.6 (GND3), U6.12 (GND4), U7.1 (GND_1), U7.7 (GND_2), U8.6 (GDN), U8.7 (GDN); also elsewhere on the board
ISM330_CS: U8.12 (CS); also elsewhere on the board
ISM330_INT1: U8.4 (INT1); also elsewhere on the board
ISM330_INT2: U8.9 (INT2); also elsewhere on the board
ISM330_MISO: U8.1 (SDO); also elsewhere on the board
ISM330_MOSI: U8.14 (SDA); also elsewhere on the board
ISM330_SCK: U8.13 (SCL); also elsewhere on the board
LSM303_INT1: U5.12 (INT1_XL); also elsewhere on the board
LSM303_INT2: U5.11 (INT2_XL); also elsewhere on the board
LSM303_INT_MAG: U5.7 (INT_MAG/DRDY); also elsewhere on the board
unnamed: C43.1, U5.5 (C1)
unnamed: R17.2, U5.2 (CS)
unnamed: R22.1, U7.5 (SDO)
unnamed: R23.2, U7.2 (CSB)
VL53_EN: U6.5 (XSHUT); also elsewhere on the board
VL53_INT: U6.7 (GPIO1); also elsewhere on the board
VL53_SCL: R21.2, U6.10 (SCL); also elsewhere on the board
VL53_SDA: R20.2, U6.9 (SDA); also elsewhere on the board
