MarcinWojewodzic/C5/Hardware/C5W1B1V1.0/Kicad/C5W1B1V1.0.kicad_pcb

## KiCad design Hardware/C5W1B1V1.0/Kicad/C5W1B1V1.0.kicad_pcb (continued)

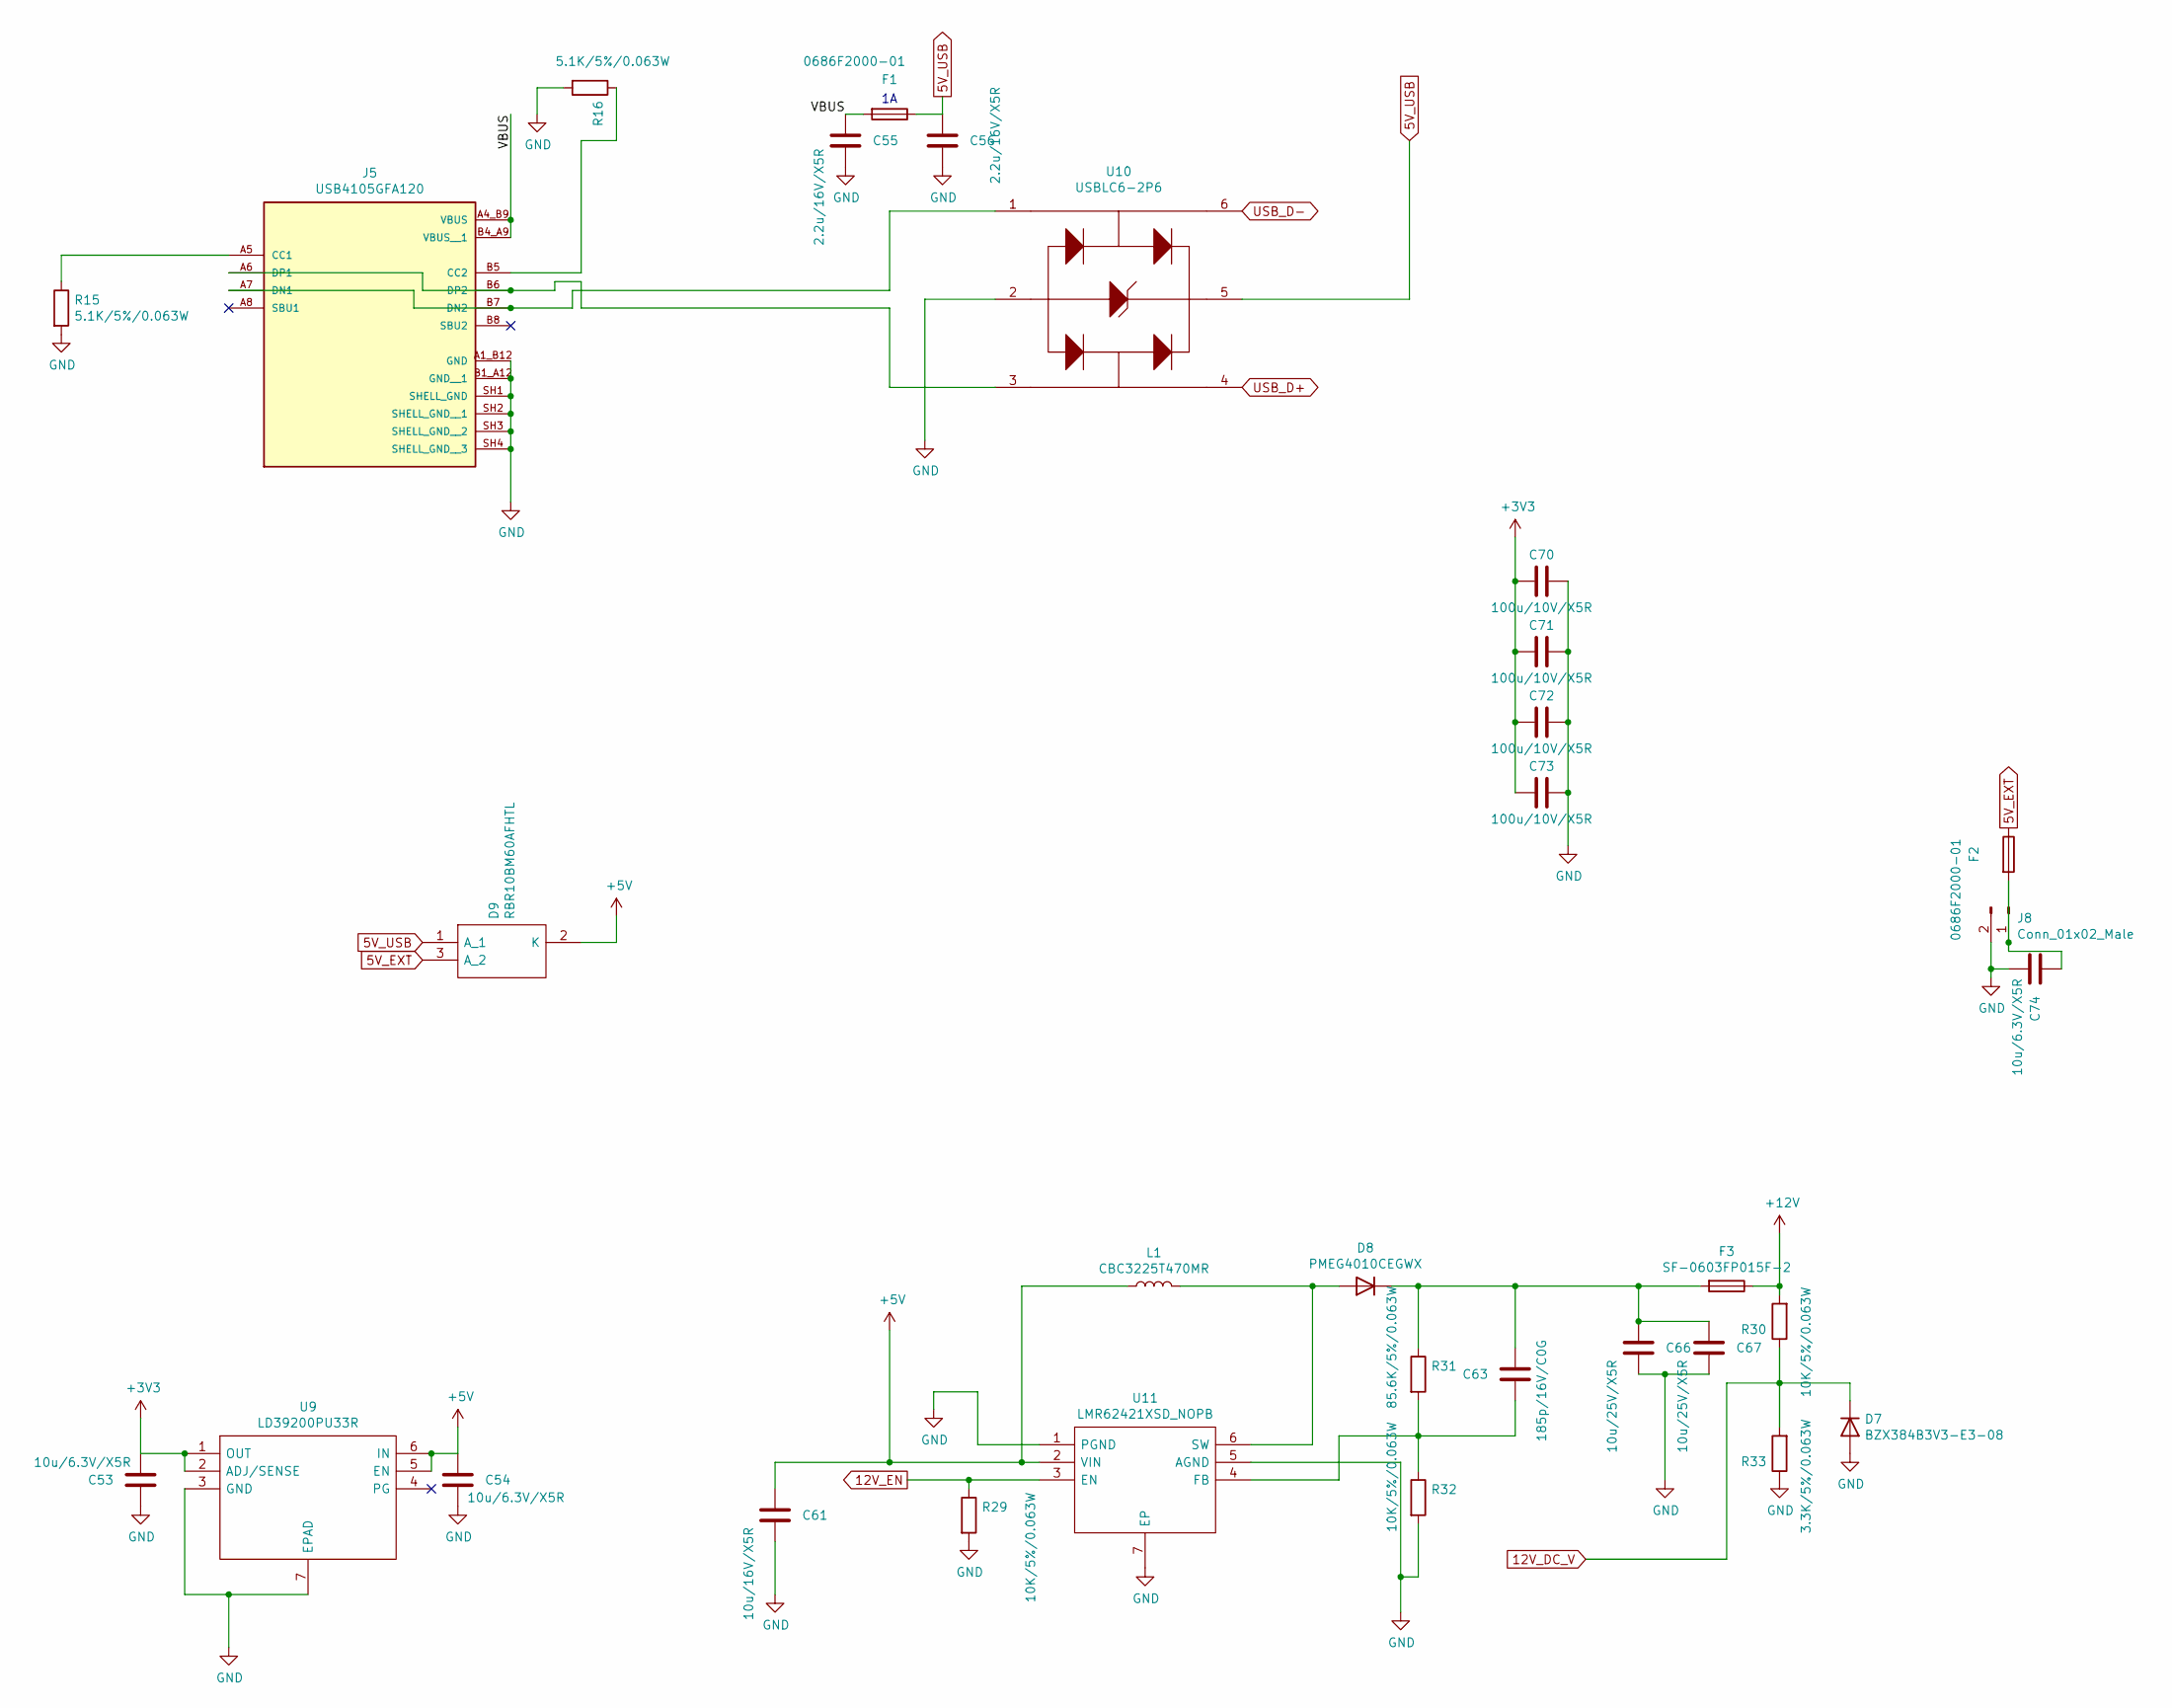
[picture p25: schematic Power.sch]

Parts:
C53, C54, C74: 10u/6.3V/X5R; C_0402_1005Metric
C55, C56: 2.2u/16V/X5R; C_0402_1005Metric
C61: 10u/16V/X5R; C_0603_1608Metric
C63: 185p/16V/C0G; C_0402_1005Metric
C66, C67: 10u/25V/X5R; C_1206_3216Metric
C70, C71, C72, C73: 100u/10V/X5R; C_1206_3216Metric
D7: BZX384B3V3-E3-08; D_SOD-323
D8: PMEG4010CEGWX; D_SOD-123
D9: RBR10BM60AFHTL; RD3P175SNFRATL; Manufacturer_Part_Number RBR10BM60AFHTL; Mouser Part Number 755-RBR10BM60AFHTL
F1, F2: 0686F2000-01; Fuse_0603_1608Metric
F3: SF-0603FP015F-2; Fuse_0603_1608Metric
J5: USB4105GFA120; GCT_USB4105GFA120; PARTREV B3
J8: Conn_01x02_Male; TerminalBlock_bornier-2_P5.08mm
L1: CBC3225T470MR; L_1210_3225Metric
R15, R16: 5.1K/5%/0.063W; R_0402_1005Metric
R29, R30, R32: 10K/5%/0.063W; R_0402_1005Metric
R31: 85.6K/5%/0.063W; R_0402_1005Metric
R33: 3.3K/5%/0.063W; R_0402_1005Metric
U9: LD39200PU33R; SON95P300X300X100-7N-D; Manufacturer_Part_Number LD39200PU33R; Mouser Part Number 511-LD39200PU33R
U10: USBLC6-2P6; USBLC62P6; Manufacturer_Part_Number USBLC6-2P6; Mouser Part Number 511-USBLC6-2P6
U11: LMR62421XSD_NOPB; SON95P300X300X80-7N; Manufacturer_Part_Number LMR62421XSD/NOPB; Mouser Part Number 595-LMR62421XSD/NOPB

Connections:
5V_EXT: D9.3 (A_2), F2.1
5V_USB: C56.1, D9.1 (A_1), F1.1, U10.5
12V_DC_V: D7.1 (K), R30.1, R33.2; also elsewhere on the board
12V_EN: R29.1, U11.3 (EN); also elsewhere on the board
+3V3: C53.2, C70.2, C71.2, C72.2, C73.2, U9.1 (OUT), U9.2 (ADJ/SENSE); also elsewhere on the board
+5V: C54.1, C61.1, D9.2 (K), L1.1, U9.5 (EN), U9.6 (IN), U11.2 (VIN); also elsewhere on the board
+12V: F3.1, R30.2; also elsewhere on the board
/Power/VBUS: C55.1, F1.2, J5.A4_B9 (VBUS), J5.B4_A9 (VBUS__1)
GND: C53.1, C54.2, C55.2, C56.2, C61.2, C66.2, C67.2, C70.1, C71.1, C72.1, C73.1, C74.2, D7.2 (A), J5.A1_B12 (GND), J5.B1_A12 (GND__1), J5.SH1 (SHELL_GND), J5.SH2 (SHELL_GND__1), J5.SH3 (SHELL_GND__2), J5.SH4 (SHELL_GND__3), J8.2, R15.2, R16.2, R29.2, R32.2, R33.1, U9.3 (GND), U9.7 (EPAD), U10.2, U11.1 (PGND), U11.5 (AGND), U11.7 (EP); also elsewhere on the board
unnamed: C63.1, R31.2, R32.1, U11.4 (FB)
unnamed: C63.2, C66.1, C67.1, D8.1 (K), F3.2, R31.1
unnamed: C74.1, F2.2, J8.1
unnamed: D8.2 (A), L1.2, U11.6 (SW)
unnamed: J5.A5 (CC1), R15.1
unnamed: J5.A6 (DP1), J5.B6 (DP2), U10.3
unnamed: J5.A7 (DN1), J5.B7 (DN2), U10.1
unnamed: J5.B5 (CC2), R16.1
USB_D+: U10.4; also elsewhere on the board
USB_D-: U10.6; also elsewhere on the board

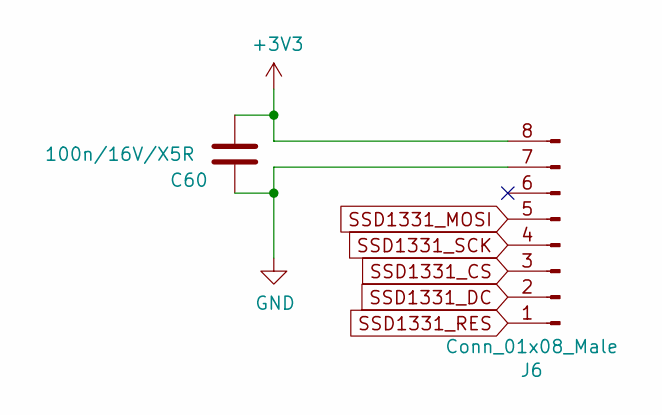
[picture p26: schematic Screen.sch]

Parts:
C60: 100n/16V/X5R; C_0402_1005Metric
J6: Conn_01x08_Male; PinHeader_1x08_P2.54mm_Vertical

Connections:
+3V3: C60.2, J6.8; also elsewhere on the board
GND: C60.1, J6.7; also elsewhere on the board
SSD1331_CS: J6.3; also elsewhere on the board
SSD1331_DC: J6.2; also elsewhere on the board
SSD1331_MOSI: J6.5; also elsewhere on the board
SSD1331_RES: J6.1; also elsewhere on the board
SSD1331_SCK: J6.4; also elsewhere on the board

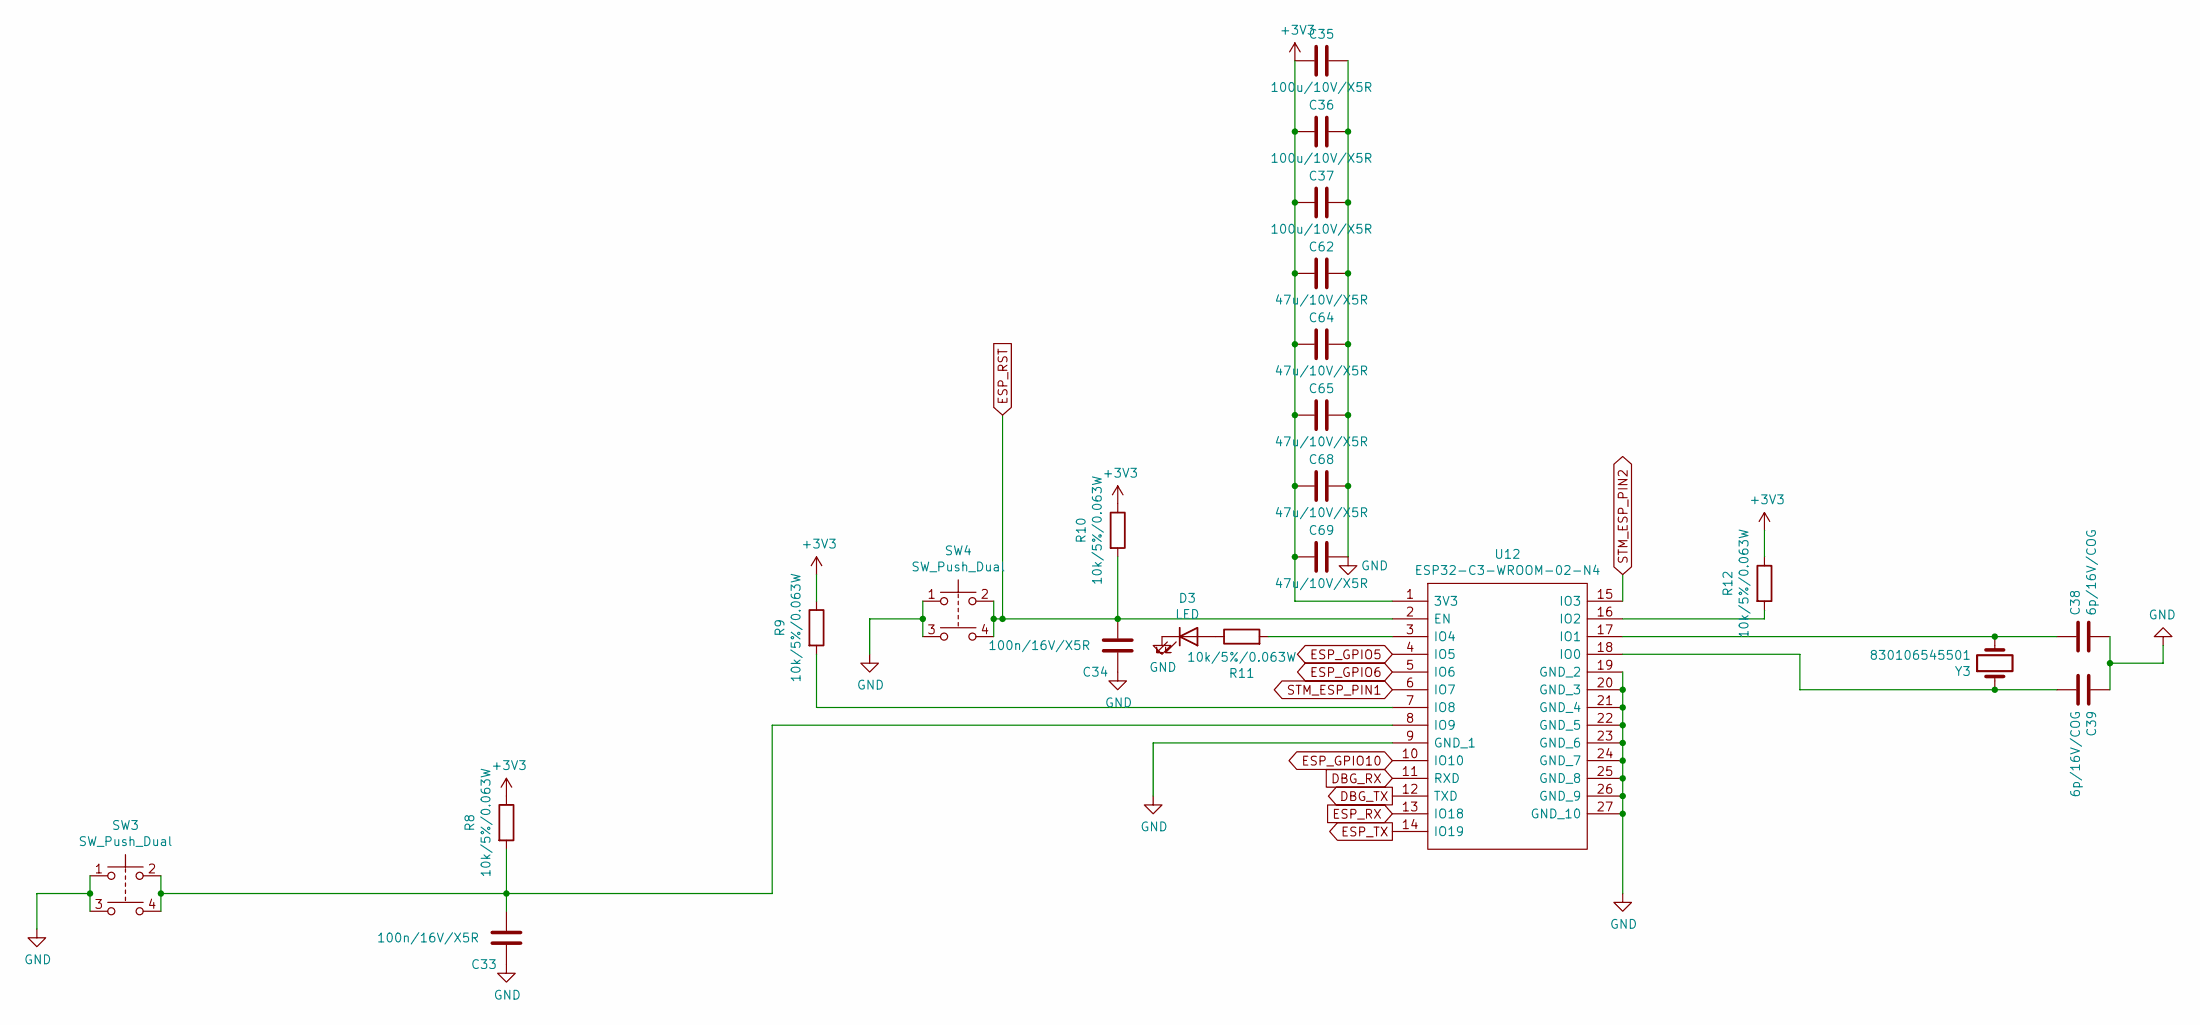
[picture p27: schematic ESP.sch]

Parts:
C33, C34: 100n/16V/X5R; C_0402_1005Metric
C35, C36, C37: 100u/10V/X5R; C_1206_3216Metric
C38, C39: 6p/16V/COG; C_0402_1005Metric
C62, C64, C65, C68, C69: 47u/10V/X5R; C_0805_2012Metric
D3: LED; LED_0805_2012Metric
R8, R9, R10, R11, R12: 10k/5%/0.063W; R_0402_1005Metric
SW3, SW4: SW_Push_Dual; SW_Push_1P1T_NO_6x6mm_H9.5mm
U12: ESP32-C3-WROOM-02-N4; ESP32C3WROOM02N4; Manufacturer_Part_Number ESP32-C3-WROOM-02-N4; Mouser Part Number 356-ESP32C3WROOM02N4
Y3: 830106545501; Crystal_SMD_2012-2Pin_2.0x1.2mm

Connections:
+3V3: C35.2, C36.2, C37.2, C62.2, C64.2, C65.2, C68.2, C69.2, R8.1, R9.1, R10.1, R12.1, U12.1 (3V3); also elsewhere on the board
DBG_RX: U12.11 (RXD); also elsewhere on the board
DBG_TX: U12.12 (TXD); also elsewhere on the board
ESP_GPIO5: U12.4 (IO5); also elsewhere on the board
ESP_GPIO6: U12.5 (IO6); also elsewhere on the board
ESP_GPIO10: U12.10 (IO10); also elsewhere on the board
ESP_RST: C34.2, R10.2, SW4.2, SW4.4, U12.2 (EN); also elsewhere on the board
ESP_RX: U12.13 (IO18); also elsewhere on the board
ESP_TX: U12.14 (IO19); also elsewhere on the board
GND: C33.1, C34.1, C35.1, C36.1, C37.1, C38.2, C39.1, C62.1, C64.1, C65.1, C68.1, C69.1, D3.1 (K), SW3.1, SW3.3, SW4.1, SW4.3, U12.9 (GND_1), U12.19 (GND_2), U12.20 (GND_3), U12.21 (GND_4), U12.22 (GND_5), U12.23 (GND_6), U12.24 (GND_7), U12.25 (GND_8), U12.26 (GND_9), U12.27 (GND_10); also elsewhere on the board
unnamed: C33.2, R8.2, SW3.2, SW3.4, U12.8 (IO9)
unnamed: C38.1, U12.17 (IO1), Y3.2
unnamed: C39.2, U12.18 (IO0), Y3.1
unnamed: D3.2 (A), R11.1
unnamed: R9.2, U12.7 (IO8)
unnamed: R11.2, U12.3 (IO4)
unnamed: R12.2, U12.16 (IO2)
STM_ESP_PIN1: U12.6 (IO7); also elsewhere on the board
STM_ESP_PIN2: U12.15 (IO3); also elsewhere on the board

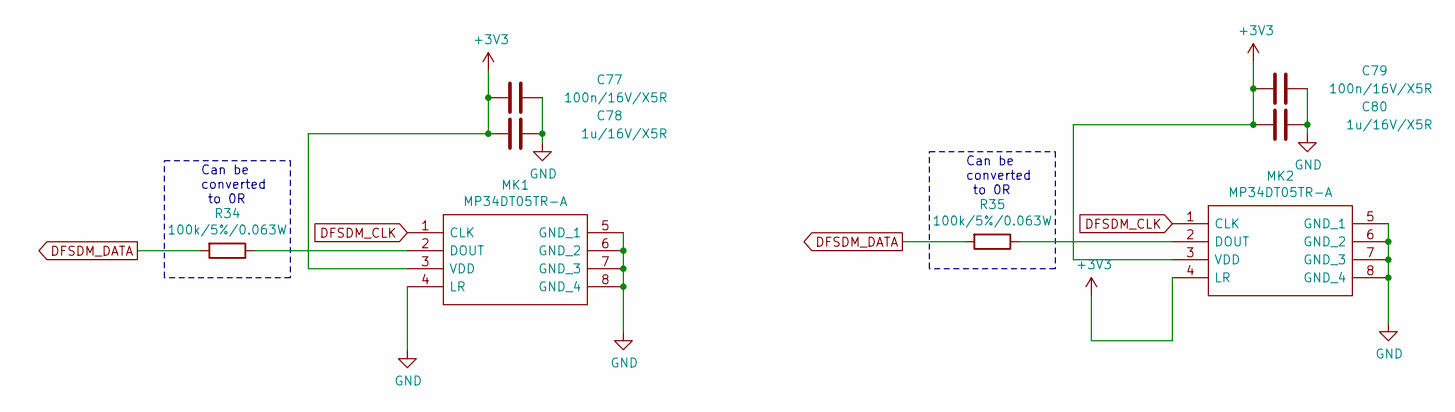
[picture p28: schematic Audio.sch]

Parts:
C77, C79: 100n/16V/X5R; C_0402_1005Metric
C78, C80: 1u/16V/X5R; C_0402_1005Metric
MK1, MK2: MP34DT05TR-A; MP34DT05TRA; Manufacturer_Part_Number MP34DT05TR-A
R34, R35: 100k/5%/0.063W; R_0402_1005Metric

Connections:
+3V3: C77.1, C78.1, C79.1, C80.1, MK1.3 (VDD), MK2.3 (VDD), MK2.4 (LR); also elsewhere on the board
DFSDM_CLK: MK1.1 (CLK), MK2.1 (CLK); also elsewhere on the board
DFSDM_DATA: R34.2, R35.2; also elsewhere on the board
GND: C77.2, C78.2, C79.2, C80.2, MK1.4 (LR), MK1.5 (GND_1), MK1.6 (GND_2), MK1.7 (GND_3), MK1.8 (GND_4), MK2.5 (GND_1), MK2.6 (GND_2), MK2.7 (GND_3), MK2.8 (GND_4); also elsewhere on the board
unnamed: MK1.2 (DOUT), R34.1
unnamed: MK2.2 (DOUT), R35.1

Notes on the sheet:
Can be converted to 0R

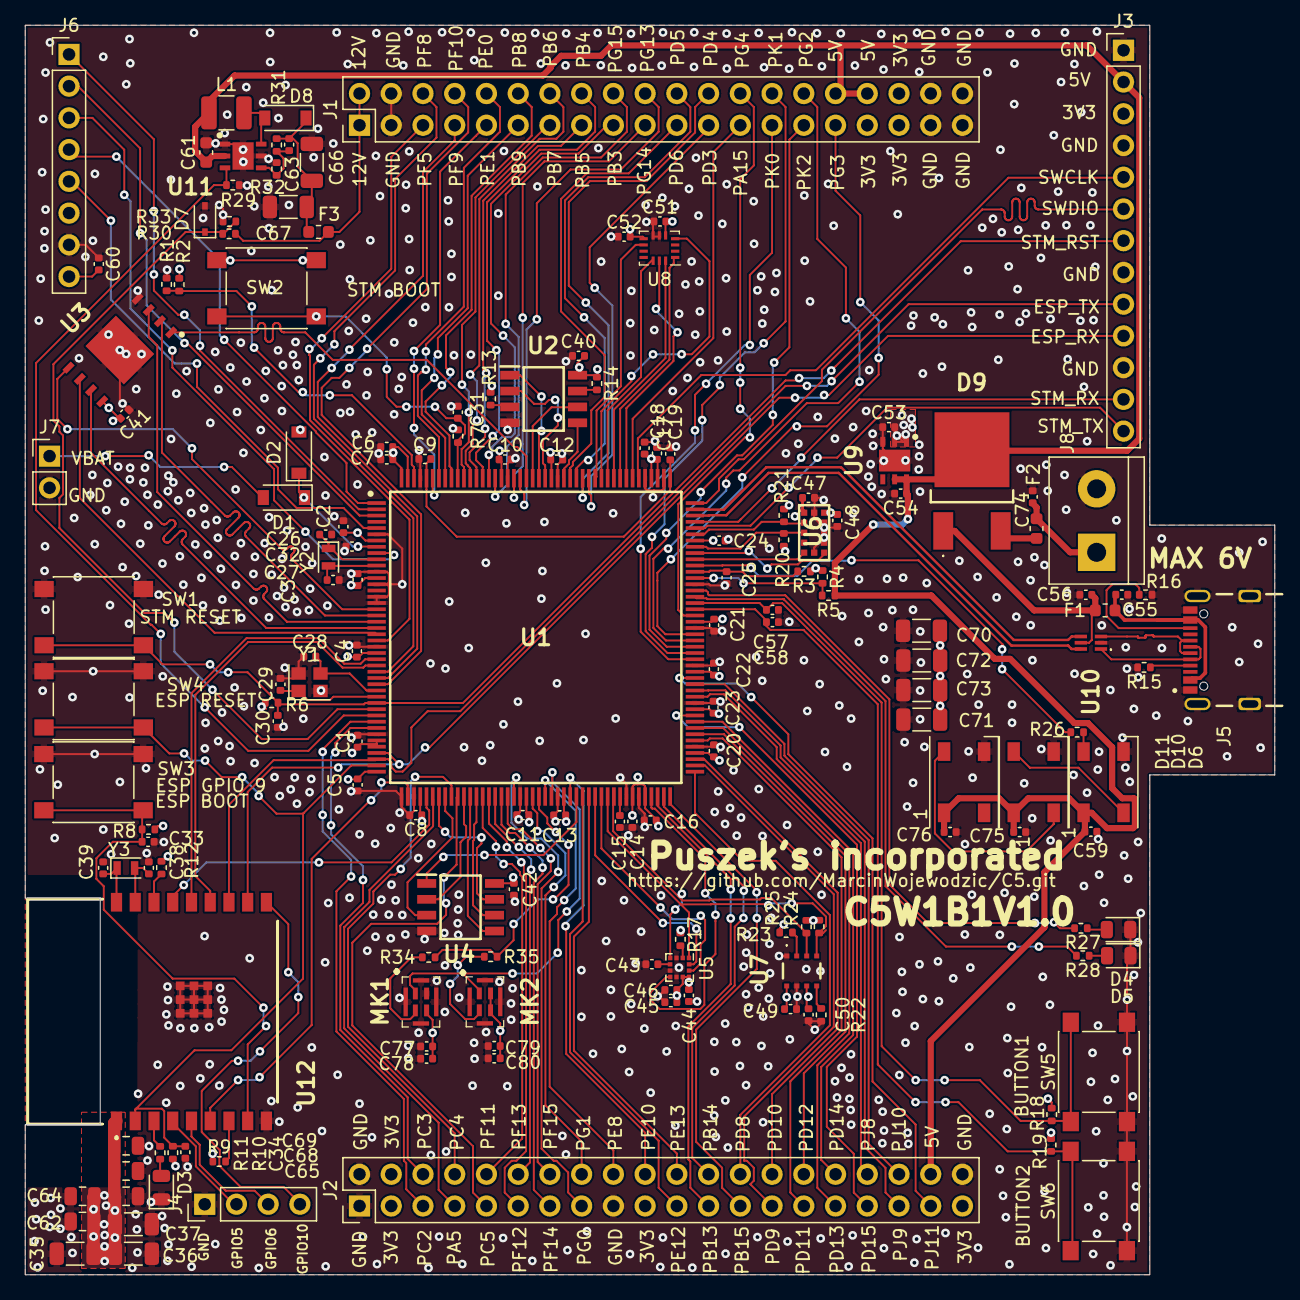
[picture p29: board C5W1B1V1.0.kicad_pcb from above]

Board: 4 copper layers, 100.0 x 100.0 mm, 161 parts (0 on the bottom side), 167 nets.
