MarcinWojewodzic/C5/Firmware/C5/C5.ioc

Mcu.UserName=STM32H735IGTx
PA0.Signal=UART4_TX
PA1.Signal=UART4_RX
PA10.Signal=USART1_RX
PA11.Signal=USB_OTG_HS_DM
PA12.Signal=USB_OTG_HS_DP
PA13(JTMS/SWDIO).Signal=DEBUG_JTMS-SWDIO
PA14(JTCK/SWCLK).Signal=DEBUG_JTCK-SWCLK
PA2.GPIO_Label=ESP_RST
PA2.Signal=GPIO_Output
PA3.GPIO_Label=STM_ESP_PIN1
PA3.Signal=GPIO_Input
PA4.GPIO_Label=STM_ESP_PIN2
PA4.Signal=GPIO_Input
PA6.Signal=OCTOSPIM_P1_IO3
PA7.Signal=OCTOSPIM_P1_IO2
PA8.Signal=I2C3_SCL
PA9.Signal=USART1_TX
PB0.Signal=OCTOSPIM_P1_IO1
PB1.Signal=OCTOSPIM_P1_IO0
PB10.Signal=I2C2_SCL
PB11.Signal=I2C2_SDA
PB12.GPIO_Label=LSM303_INT_MAG
PB12.Signal=GPXTI12
PB2.Signal=OCTOSPIM_P1_CLK
PB6.Signal=I2C1_SCL
PB7.Signal=I2C1_SDA
PC10.Signal=SPI3_SCK
PC11.Signal=SPI3_MISO
PC12.Signal=SPI3_MOSI
PC13.GPIO_Label=SSD1331_CS
PC13.Signal=GPIO_Output
PC14-OSC32_IN.Signal=RCC_OSC32_IN
PC15-OSC32_OUT.Signal=RCC_OSC32_OUT
PC4.Signal=S_CKIN2DFSDM1
PC6.GPIO_Label=WS2812
PC6.Signal=S_TIM3_CH1
PC7.GPIO_Label=VL53_INT
PC7.Signal=GPXTI7
PC8.GPIO_Label=VL53_EN
PC8.Signal=GPXTI8
PC9.Signal=I2C3_SDA
PD0.GPIO_Label=ISM330_CS
PD0.Signal=GPIO_Output
PD1.GPIO_Label=ISM330_INT1
PD1.Signal=GPXTI1
PD2.GPIO_Label=ISM330_INT2
PD2.Signal=GPXTI2
PD7.Signal=SPI1_MOSI
PE11.Signal=OCTOSPIM_P1_NCS
PE14.GPIO_Label=LSM303_INT2
PE14.Signal=GPXTI14
PE15.GPIO_Label=LSM303_INT1
PE15.Signal=GPXTI15
PE2.Signal=SPI4_SCK
PE3.GPIO_Label=SSD1331_RES
PE3.Signal=GPIO_Output
PE4.GPIO_Label=SSD1331_DC
PE4.Signal=GPIO_Output
PE6.Signal=SPI4_MOSI
PE7.Signal=S_DATAIN2DFSDM1
PE9.Signal=S_CKOUTDFSDM1
PF0.Signal=OCTOSPIM_P2_IO0
PF1.Signal=OCTOSPIM_P2_IO1
PF2.Signal=OCTOSPIM_P2_IO2
PF3.Signal=OCTOSPIM_P2_IO3
PF4.Signal=OCTOSPIM_P2_CLK
PF6.Signal=UART7_RX
PF7.Signal=UART7_TX
PG10.GPIO_Label=FRAM_CS
PG10.Signal=GPIO_Output
PG11.Signal=SPI1_SCK
PG12.Signal=OCTOSPIM_P2_NCS
PG7.GPIO_Label=LED2
PG7.Signal=GPIO_Output
PG8.GPIO_Label=LED1
PG8.Signal=GPIO_Output
PG9.Signal=SPI1_MISO
PH0-OSC_IN.Signal=RCC_OSC_IN
PH1-OSC_OUT.Signal=RCC_OSC_OUT
