MarcinWojewodzic/C5/(commit log)

2023-04-23 Dodano początkowe zasilanie
    [Procek1.sch]
2023-05-07 Dodano schemat ISN
    [BME688.sch, BME688.stp, C5V1.kicad_pcb, C5V1.sch, ISM330ISN.sch, Procek1.sch]
2024-06-08 Podstawowy schemat
    [216990-0003.stp, APS6404L-3SQR-SN.stp, BME688.sch, BME688.stp, C5V1.kicad_pcb, C5V1.sch, C5W1B1V1.0.kicad_pcb, C5W1B1V1.0.sch]
2024-06-27 Linie PC0-PE13
    [0.96in Color OLED.stp, C5W1B1V1.0.kicad_pcb, IO.sch, Sensors.sch, uC.sch]
2024-06-30 Rozlana masa
    [C5W1B1V1.0.kicad_pcb, ESP.sch, IO.sch, LMR62421XSD_NOPB.stp, Power.sch, SRN6045TA-101M.stp, Screen.sch, uC.sch]
2024-06-30 Dodano opisy
    [C5W1B1V1.0.kicad_pcb]
2024-07-05 End PCB
    [C5W1B1V1.0.kicad_pcb, ESP.sch, Power.sch]
2024-11-08 Skończono PCB
    [0.96in Color OLED.stp, 216990-0003.stp, APS6404L-3SQR-SN.stp, BME688.stp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]
2024-11-15 Dodano mikrofony i więcej WS2812B
    [Audio.sch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]
2024-11-16 Drobne poprawki
    [C5W1B1V1.0-B_Cu.gbl, C5W1B1V1.0-B_Mask.gbs, C5W1B1V1.0-B_Paste.gbp, C5W1B1V1.0-B_SilkS.gbo, C5W1B1V1.0-Edge_Cuts.gm1, C5W1B1V1.0-F_Cu.gtl, C5W1B1V1.0-F_Mask.gts, C5W1B1V1.0-F_Paste.gtp]
